drewarney/Turbocore-Maglev-Compressor-analysis/report/figures/S2_TipLeakage_streamlines.png

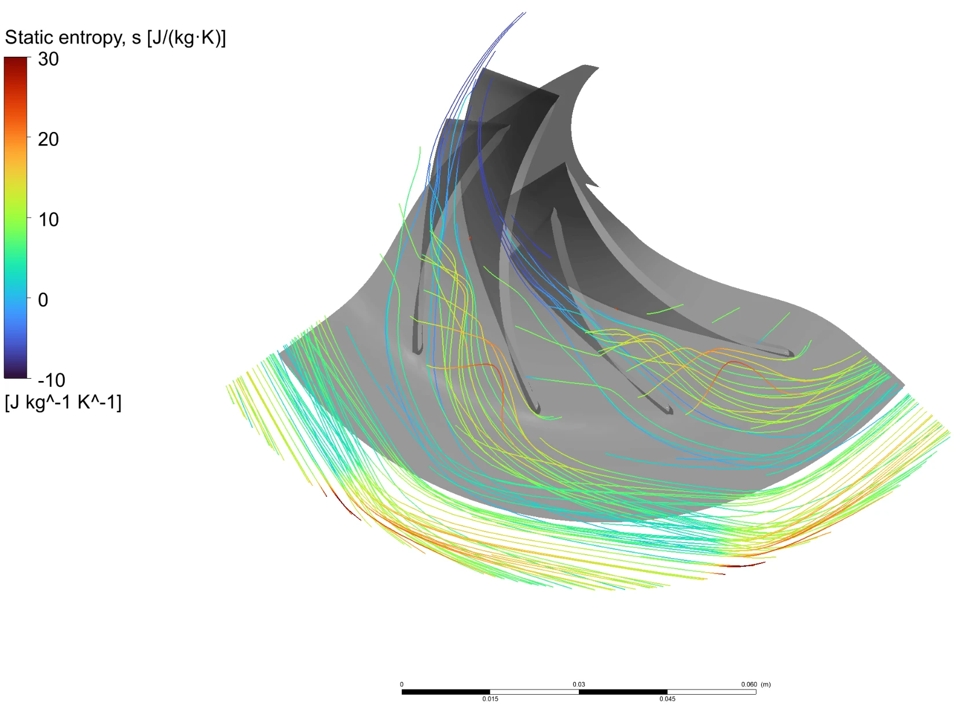
report/figures/S2_TipLeakage_streamlines.png
