drewarney/Turbocore-Maglev-Compressor-analysis/drawings/SK-001_impeller_mounting.pdf

# (a) Clamped stack: nut / tie bolt, torque by face friction

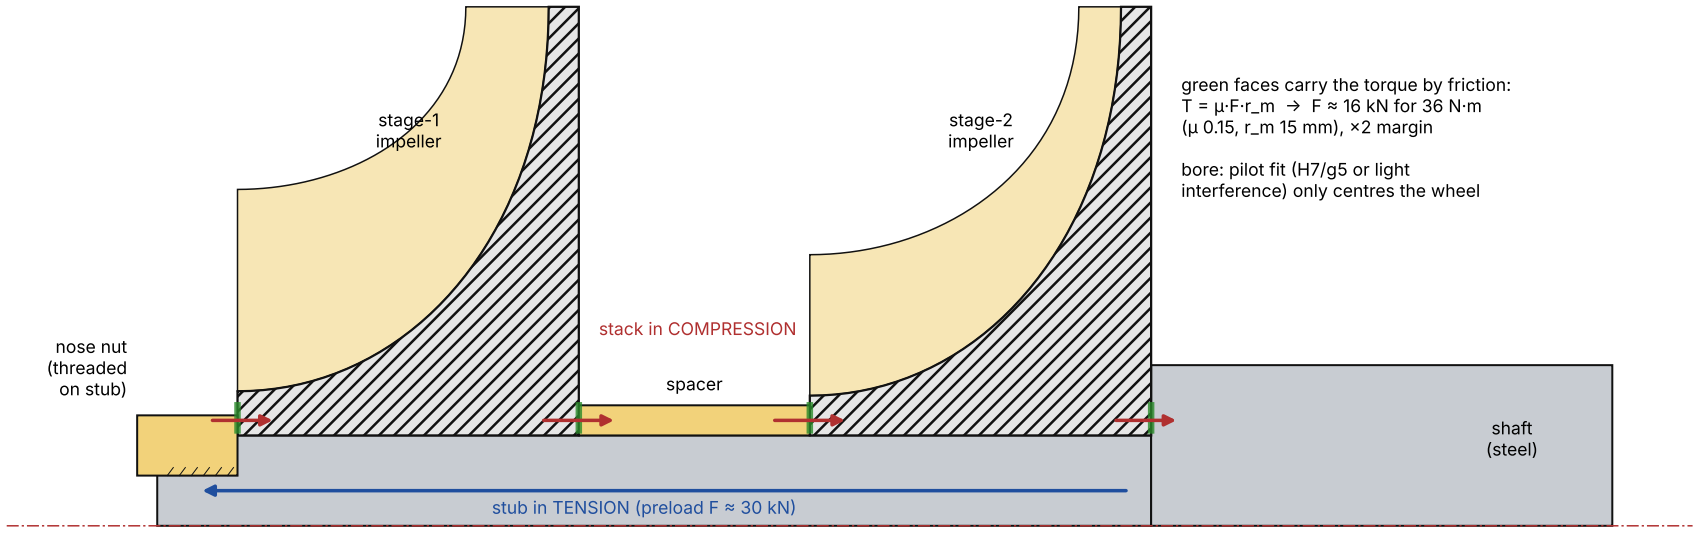
[picture p19: figure]
shaft (steel); stage-1 impeller; stage-2 impeller; spacer; nose nut (threaded on stub); stub in TENSION (preload F ≈ 30 kN); stack in COMPRESSION; T = μ·F·r_m → F ≈ 16 kN for 36 N·m (μ 0.15, r_m 15 mm), ×2 margin; bore: pilot fit (H7/g5 or light; interference) only centres the wheel

green faces carry the torque by friction:

+ easy to assemble and service
+ balance stays repeatable
− needs flat, square faces (datum A)

# (b) Shrink (interference) fit: torque by bore pressure

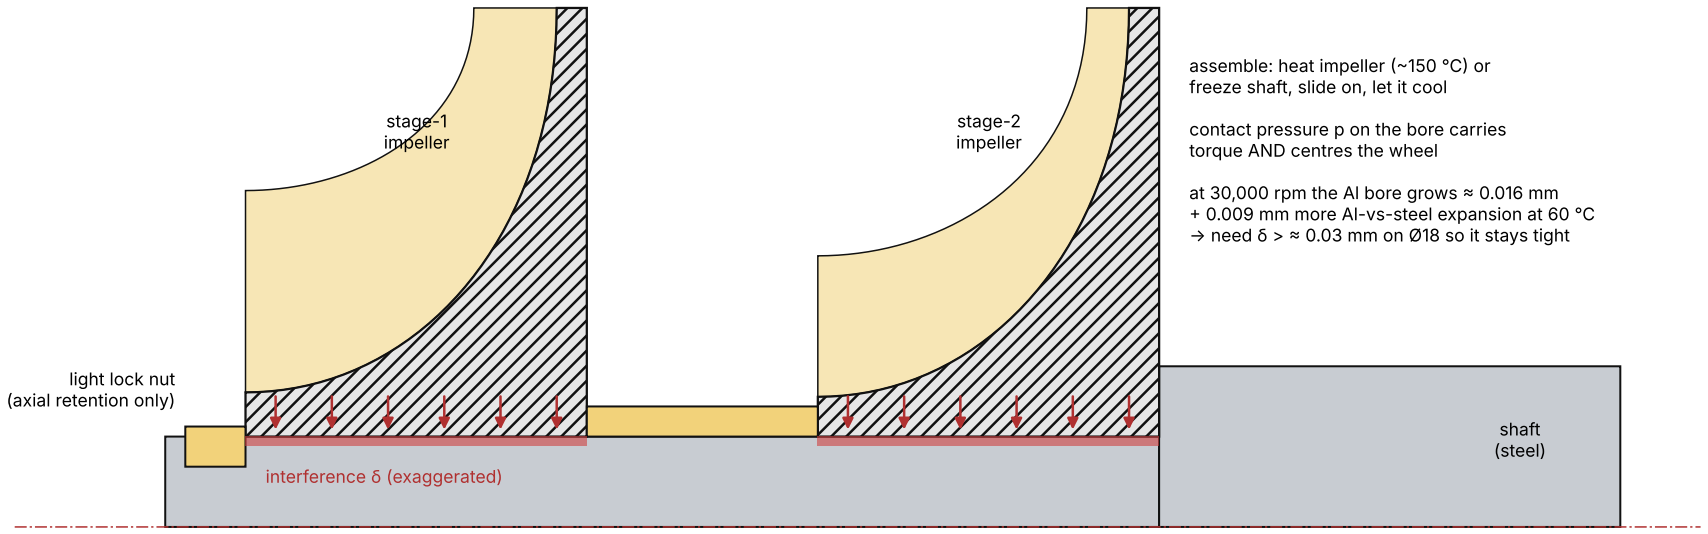
[picture p20: figure]
shaft (steel); stage-1 impeller; stage-2 impeller; light lock nut (axial retention only); interference δ (exaggerated); assemble: heat impeller (~150 °C) or; freeze shaft, slide on, let it cool; contact pressure p on the bore carries torque AND centres the wheel

at 30,000 rpm the Al bore grows ≈ 0.016 mm
+ 0.009 mm more Al-vs-steel expansion at 60 °C → need δ > ≈ 0.03 mm on Ø18 so it stays tight

+ no torque on the faces, very stiff
− hard to remove; heating can change 7075-T6 temper above ~120 °C
− fit loosens with speed and temperature

Half-sections above the rotor axis, to scale (layout.py). Blades in yellow, hub body hatched. Study schematic - the real Turbocor mounting is not published.
