drewarney/Turbocore-Maglev-Compressor-analysis/calcs/FBD_set.pdf

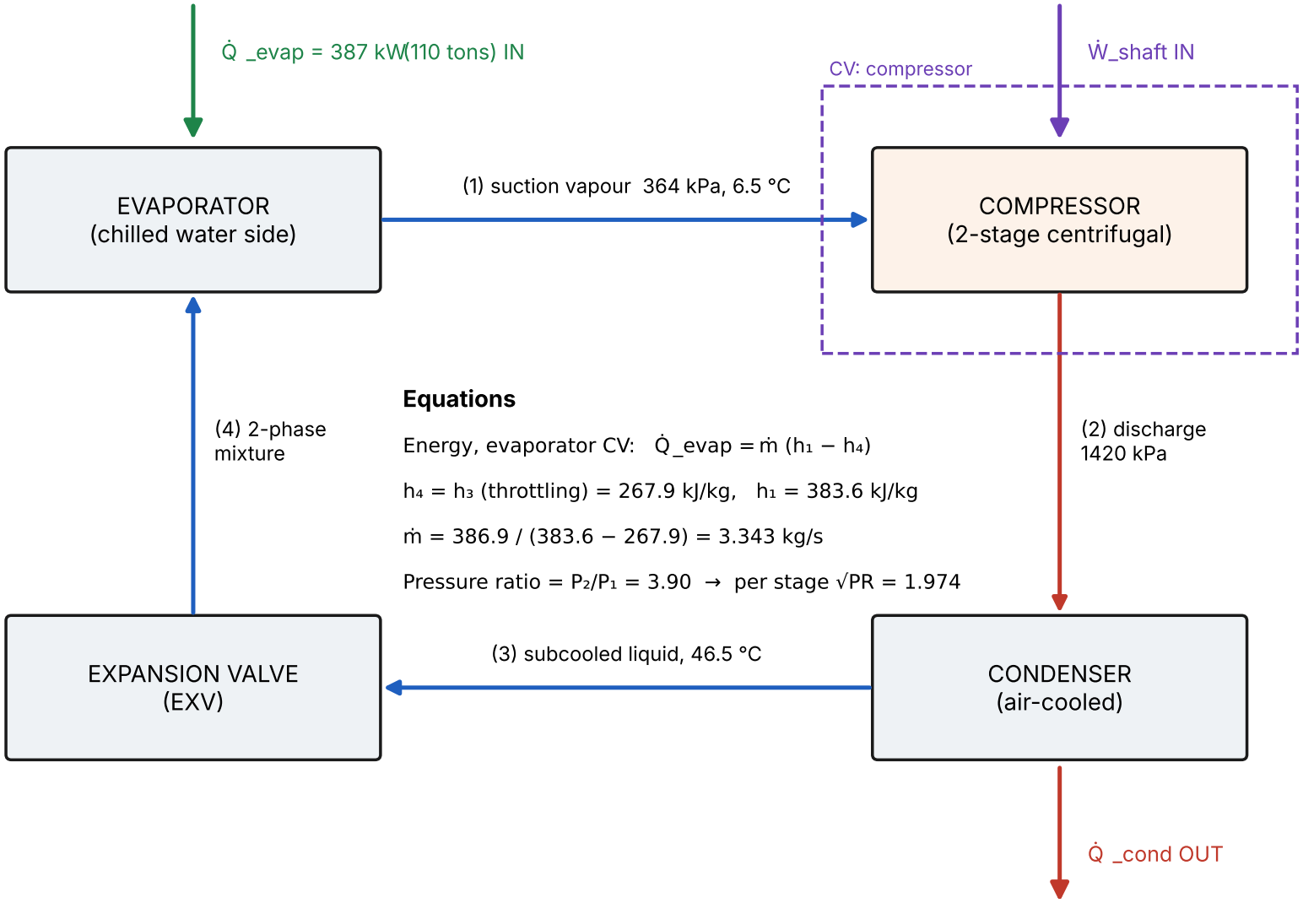
[picture p21: figure]
EVAPORATOR (chilled water side); COMPRESSOR (2-stage centrifugal); CONDENSER (air-cooled); EXPANSION VALVE (EXV); (1) suction vapour 364 kPa, 6.5 °C; (2) discharge; 1420 kPa; (3) subcooled liquid, 46.5 °C; (4) 2-phase; mixture; Q̇Q̇ _cond OUT; CV: compressor; Equations

Q̇Q̇ _evap = 387 kW (110 tons) IN | Ẇ_shaft IN

Energy, evaporator CV: Q̇Q̇ _evap = ṁ (h₁ − h₄)

h₄ = h₃ (throttling) = 267.9 kJ/kg, h₁ = 383.6 kJ/kg

ṁ = 386.9 / (383.6 − 267.9) = 3.343 kg/s

Pressure ratio = P₂/P₁ = 3.90 → per stage √PR = 1.974

# FBD-1 Chiller refrigeration cycle: system control volumes

Turbocor-class compressor study: free-body / control-volume diagrams. Numbers from scripts/hand_calcs.py.

### COMPRESSOR (stages 1 + 2)

control surface

ṁ = 3.343 kg/s
h₀₁ = 383.6 kJ/kg
P₀₁ = 364 kPa

## h₀₂ = h₀₁ + Δh₀

P₀₂ = 1420 kPa

Ẇ_gas = 110.5 kW (shaft work on gas)

Q̇Q̇ ≈ 0 (adiabatic; motor-cooling flow handled separately)

## Equations

Steady-flow energy: Ẇ = ṁ (h₀₂ − h₀₁) (Q̇Q̇ ≈ 0, ΔPE ≈ 0)

Ideal (isentropic): Δh₀s = h₂s − h₁ = 26.17 kJ/kg

Actual (meanline): Δh₀ = 33.07 kJ/kg → η_s = 0.792

Ẇ_gas = 3.343 × 33.07 = 110.5 kW

# FBD-2 Compressor control volume: first law (steady flow)

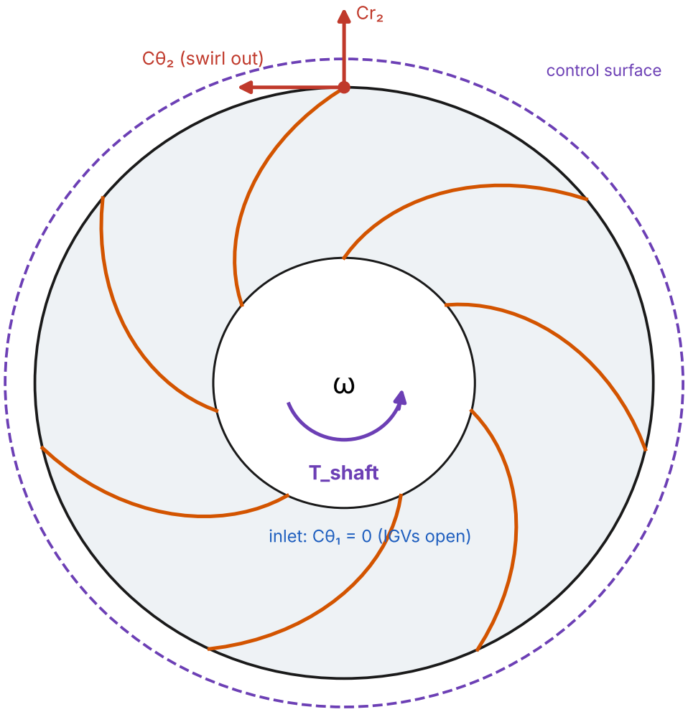
[picture p22: figure]
control surface; T_shaft; Cθ₂ (swirl out); Cr₂; inlet: Cθ₁ = 0 (IGVs open)

## Equations

Angular momentum about the shaft axis:

T_shaft = ṁ (r₂Cθ₂ − r₁Cθ₁)

Power: Ẇ = T ω = ṁ (U₂Cθ₂ − U₁Cθ₁)

With Cθ₁ = 0: Δh₀ = U₂ Cθ₂

Slip (Wiesner): σ = 1 − √(cos β₂b) / Z^0.7

Z = 14, β₂b = 40° → σ = 0.862

Cθ₂ = σU₂ − Cm₂ tan β₂b, Cm₂ = φ₂U₂

ψ = Δh₀/U₂² = σ − φ₂ tan β₂b = 0.627

U₂ = 162.4 m/s → Δh₀ = 16.53 kJ/kg

D₂ = 60U₂/(πN) = 103.4 mm (N = 30,000 rpm)

Stage-1 torque = ṁΔh₀/ω = 17.6 N·m

# FBD-3 Impeller control volume: angular momentum (Euler turbomachine equation)

## C₁ = Cm₁

= 66.7

## U₁t = 105.2

## W₁t = 124.6

## INLET (blade tip)

β₁t = atan(U₁t/Cm₁) = 57.6° from axial; M₁rel = W₁t/a₁ = 0.88

U₂ = 162.4

C₂ = 111.5 | W₂ = 75.7 blade direction (β₂b = 40°)

## EXIT (r₂ = 51.7 mm)

Cθ₂ = σU₂ − Cm₂tanβ₂b = 101.8; α₂ = atan(Cθ₂/Cm₂) = 65.9° from radial

50 m/s

Vector relation at every point: C = U + W (absolute = blade + relative)

Slip: the gas leaves at a smaller swirl than the blade angle implies (σ < 1)

# FBD-4 Velocity triangles (kinematics): stage-1 inlet tip and exit, to scale

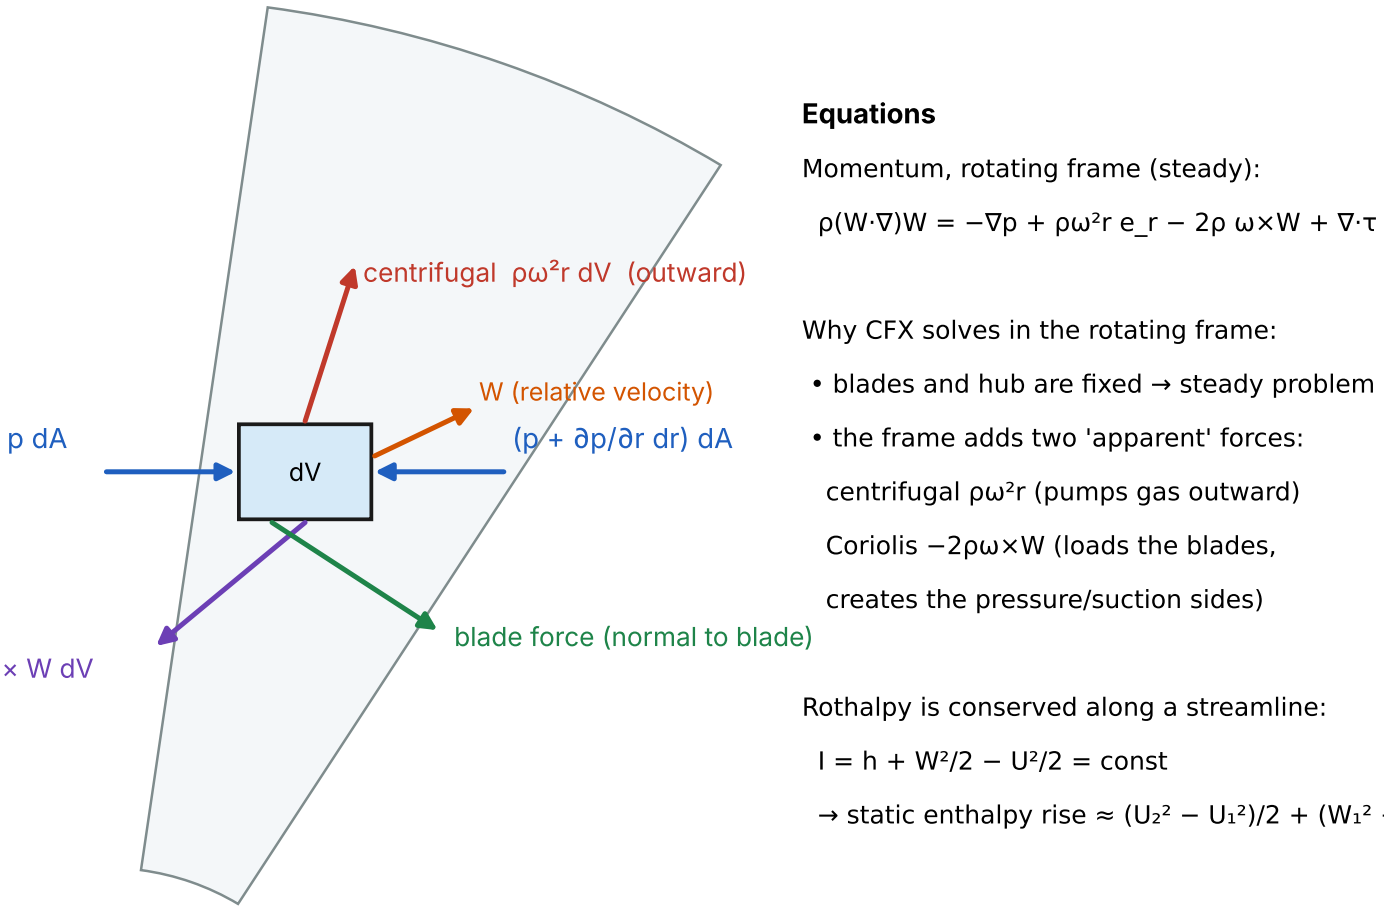
[picture p23: figure]
centrifugal ρω²r dV (outward); blade force (normal to blade); W (relative velocity); Equations; Momentum, rotating frame (steady):; ρ(W·∇)W = −∇p + ρω²r e_r − 2ρ ω×W + ∇·τ; Why CFX solves in the rotating frame:; • the frame adds two 'apparent' forces:; centrifugal ρω²r (pumps gas outward); Coriolis −2ρω×W (loads the blades,; creates the pressure/suction sides); I = h + W²/2 − U²/2 = const

axis (ω)

Coriolis −2ρ ω × W dV

- blades and hub are fixed → steady problem

Rothalpy is conserved along a streamline:

→ static enthalpy rise ≈ (U₂² − U₁²)/2 + (W₁² − W₂²)/2

# FBD-5 Fluid particle in the rotating passage (relative frame): forces per unit volume

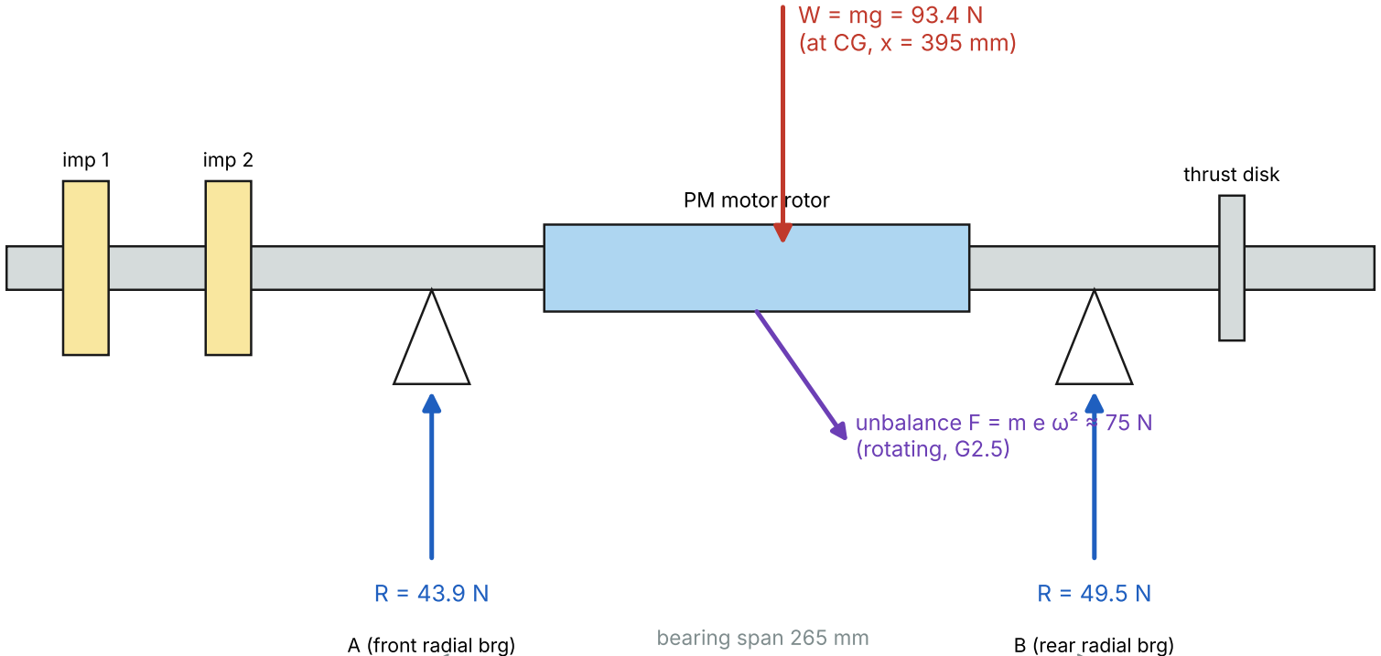
[picture p24: figure]
PM motor rotor; imp 1; imp 2; thrust disk; unbalance F = m e ω² ≈ 75 N (rotating, G2.5); bearing span 265 mm

A (front radial brg)

B (rear radial brg)

ΣF_y = 0: R_A + R_B = W = 9.52 kg × 9.81 = 93.4 N

ΣM_A = 0: R_B (x_B − x_A) = W (x_CG − x_A) → R_B = 49.5 N, R_A = 43.9 N

Unbalance (ISO 1940 G2.5): e = G/ω = 0.80 μm → F = m e ω² = 75 N (rotates at 1×)

Torque balance (steady): T_motor = T_aero = 35.9 N·m

# FBD-6 Rotor: radial free-body diagram (gravity, bearings, unbalance, torque)

## Stage-1 impeller

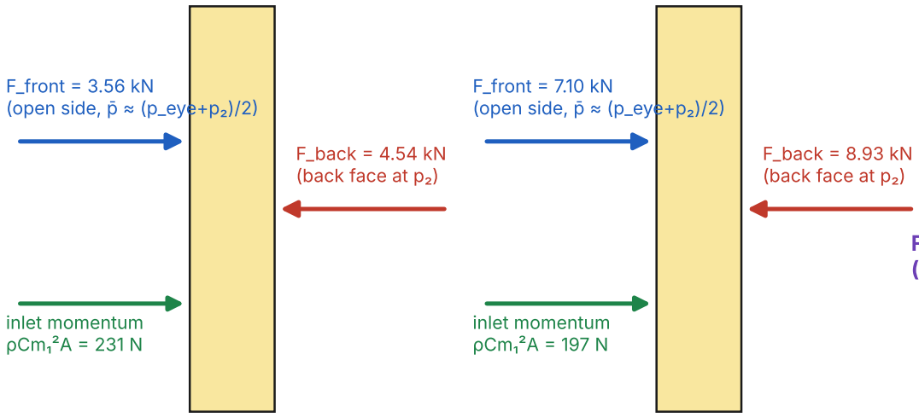
[picture p25: figure]
F_front = 3.56 kN (open side, p̄p̄ ≈ (p_eye+p₂)/2); inlet momentum ρCm₁²A = 231 N; F_back = 4.54 kN (back face at p₂); F_front = 7.10 kN (open side, p̄p̄ ≈ (p_eye+p₂)/2); inlet momentum ρCm₁²A = 197 N; F_back = 8.93 kN (back face at p₂)

## net = 0.75 kN → suction

## Stage-2 impeller

## net = 1.63 kN → suction

thrust disk

## F_axial brg ≈ 2.38 kN (reaction, toward motor)

← suction end (−X) | motor end (+X) →

Stage 1: p_eye = 324 kPa, p₂ = 572 kPa; Stage 2: p_eye = 665 kPa, p₂ = 1124 kPa

ΣF_x = 0: F_axial = Σ(F_back − F_front − ρCm₁²A) = 2.38 kN (net push toward suction; ESTIMATE)

Real machines cut this with labyrinth seals / balance holes / back-to-back cavities; the axial bearing takes the rest.

# FBD-7 Impellers: axial free-body diagram (pressure thrust, momentum, axial bearing)

## σ_θ

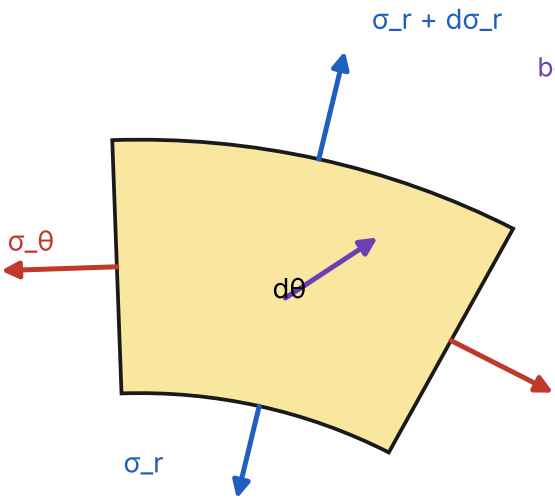
[picture p26: figure]

body force ρω²r · (r dθ dr t)

axis

## Equations

Radial equilibrium of the element:

d(r σ_r)/dr − σ_θ + ρω²r² = 0

Solution, flat disc with bore r_b (plane stress):

σ_θ,max (at bore) = (3+ν)/4 · ρω² [r₂² + (1−ν)/(3+ν) r_b²]

7075-T6: ρ = 2810 kg/m³, ν = 0.33, S_y = 503 MPa

r₂ = 51.7 mm, r_b = 9 mm

30,000 rpm: σ_θ = 62 MPa

34,500 rpm (115 %): σ_θ = 82 MPa → SF = 6.1

39,000 rpm (max): σ_θ = 105 MPa

Blades add load at the hub → confirm with FEA.

# FBD-8 Impeller disc: differential element under centrifugal load (overspeed check)
