drewarney/Turbocore-Maglev-Compressor-analysis/drawings/Turbocor_drawing_set.pdf

# COVER SHEET & DESIGN BASIS

Turbocor-class 2-stage maglev centrifugal compressor (R-513A) | SHEET 1 OF 12
DWG TC-000 SCALE - UNITS mm | REV A 2026-10-17
Reverse-engineered study model - NOT OEM geometry. Third-angle projection. General tolerance +/-0.5 mm unless noted.

# TURBOCOR-CLASS TWO-STAGE MAGNETIC-BEARING CENTRIFUGAL COMPRESSOR

Study model for SolidWorks + Ansys CFD | Basis: Danfoss Turbocor TTS350 as used in the Trane TCAA air-cooled chiller (IOM TCA-SVX001C-EN)

### DESIGN POINT (from scripts/meanline.py)

Parameter | Value
Refrigerant | R-513A (R-1234yf/R-134a 56/44 wt%)
Capacity per compressor | 110 tons (387 kW)
Sat. suction / discharge | 3.5 C / 51.5 C
Suction / discharge pressure | 364 / 1420 kPa(a)
Overall pressure ratio | 3.90
Mass flow | 3.34 kg/s
Suction volume flow | 0.177 m3/s
Design speed | 30,000 rpm
Shaft power / torque | 113 kW / 35.9 N.m
Compressor kW/ton (est.) | 1.08
Discharge temperature | 60 C
Impeller tip dia. (both stages) | 103.4 mm, tip speed 162 m/s
Blades | 7 main + 7 splitter, backsweep 40 deg
Stage PR (1 / 2) | 1.979 / 1.970

### DRAWING INDEX

DWG | Title
TC-000 | Cover sheet & design basis
TC-100/1 | General arrangement - longitudinal section
TC-100/2 | General arrangement - exterior views
TC-101 | Impeller, stage 1
TC-102 | Impeller, stage 2
TC-103 | Rotor shaft assembly
TC-110 | Inlet housing & inlet guide vanes
TC-120 | Compressor casing flow path, de-swirl vanes
TC-121 | Volute
TC-130 | Motor stator & housing
TC-140 | Magnetic & touchdown bearings
CFD-001 | CFD fluid domains & boundary conditions

### NOTES

1. All dimensions mm. Coordinate system: X = rotor axis, X=0 at suction flange face, +X toward motor.
2. Impeller/flow-path coordinates are generated - import them from cad_curves/ rather than re-typing.
3. Geometry is a physics-based preliminary design (meanline), proportioned on Turbocor TT-class
4. machines. It is NOT the OEM design and must not be used for manufacture or service parts.
5. Re-run scripts/ to change design point (speed, tonnage, refrigerant) - every sheet regenerates.
6. Materials: impellers 7075-T6 / 2618-T61 Al; casing A356-T6 Al; shaft 17-4PH; rotor sleeve CFRP;
7. laminations M270-35A / Co-Fe for bearings; housing A356-T6 / ductile iron.

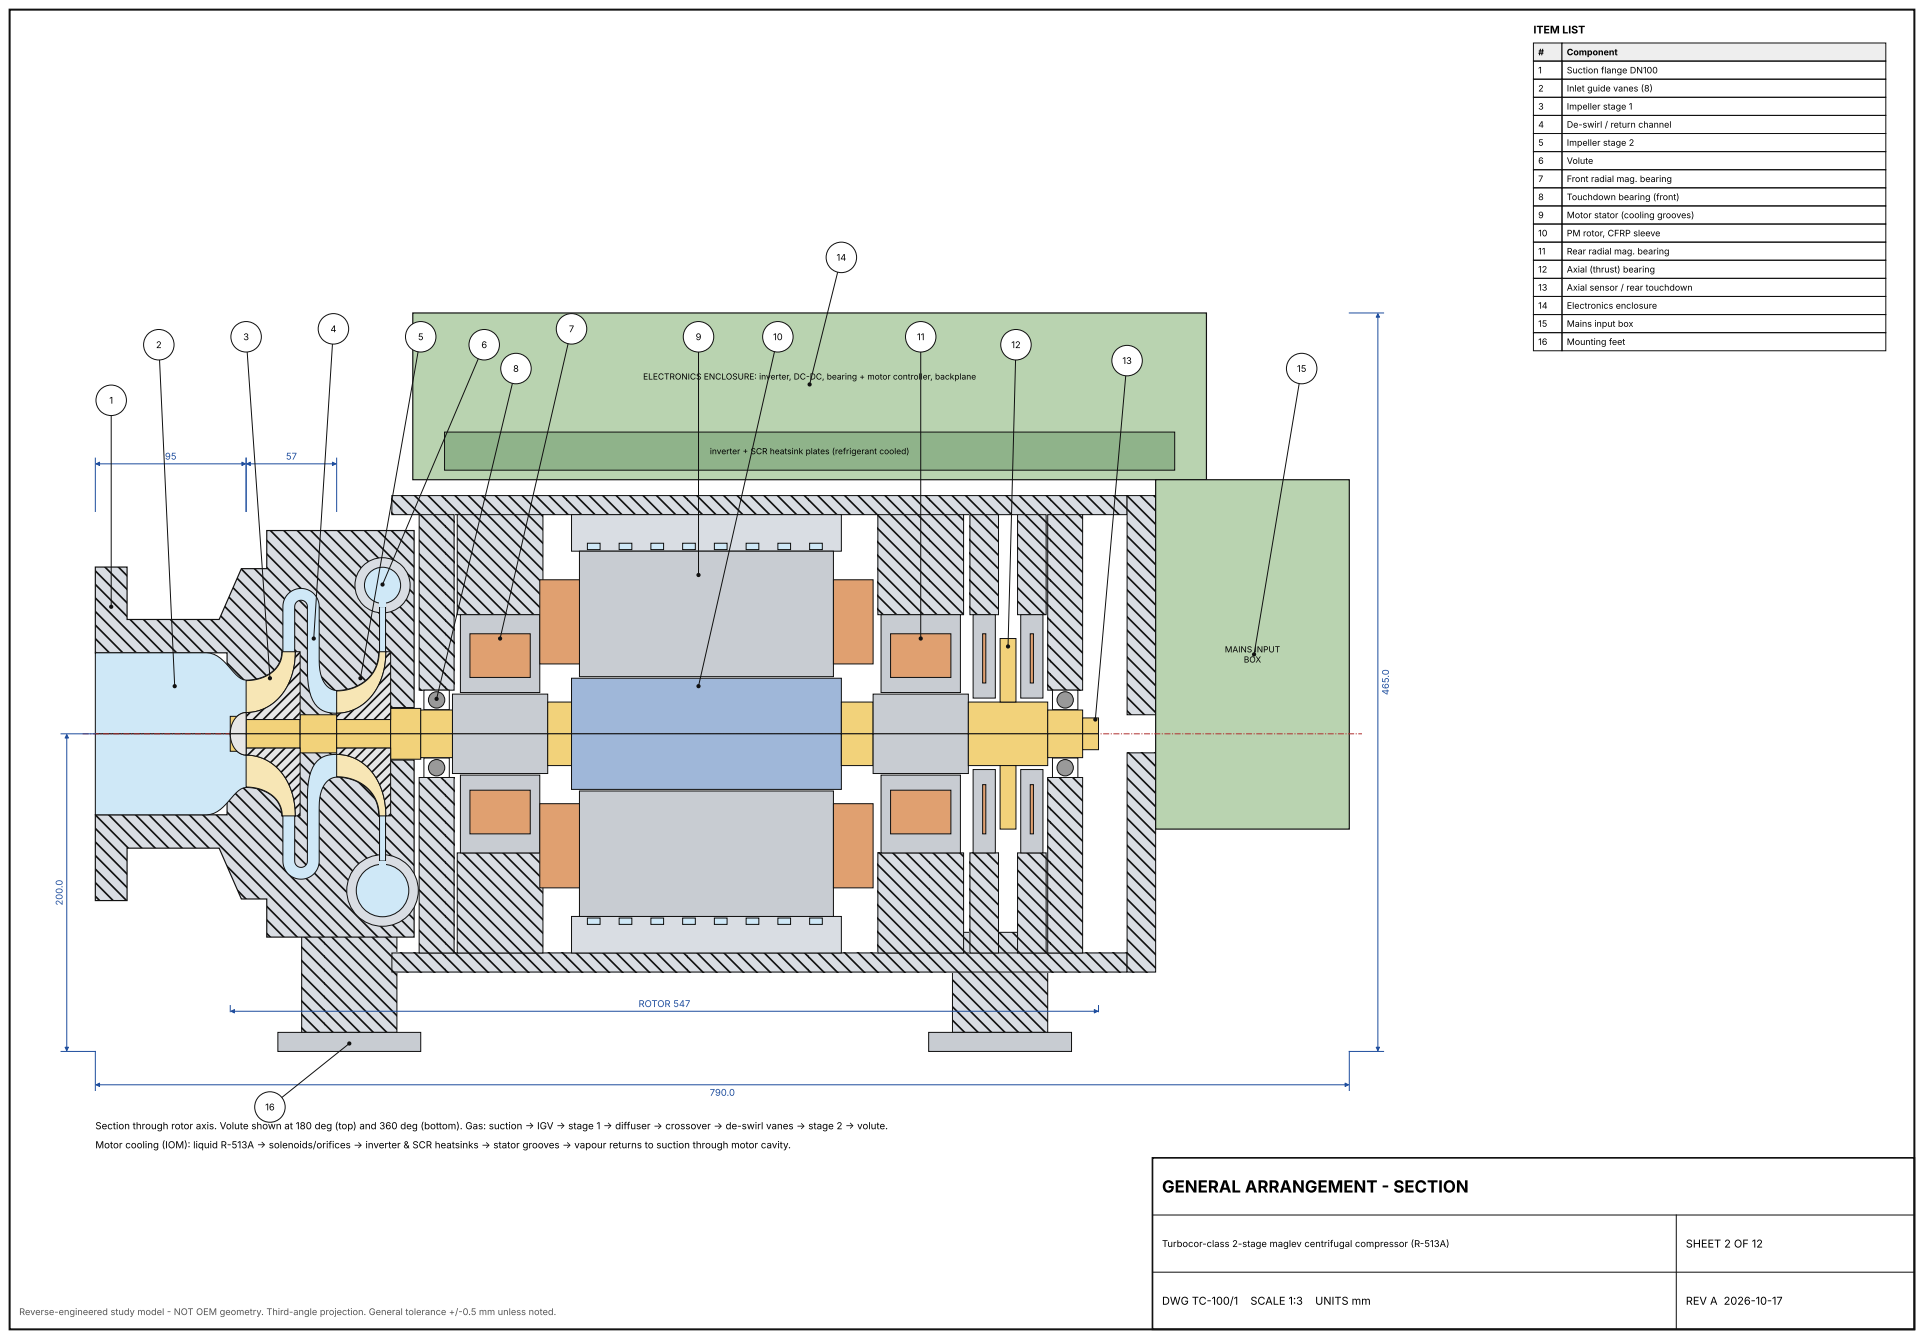
[picture p27: page 2]
SHEET 2 OF 12; ITEM LIST; Component; Suction flange DN100; Inlet guide vanes (8); Impeller stage 1; De-swirl / return channel; Impeller stage 2; Volute; Front radial mag. bearing; Touchdown bearing (front); Motor stator (cooling grooves); PM rotor, CFRP sleeve; Rear radial mag. bearing; Axial (thrust) bearing; Axial sensor / rear touchdown; Electronics enclosure; Mains input box; Mounting feet; MAINS INPUT BOX; ROTOR 547

ELECTRONICS ENCLOSURE: inverter, DC-DC, bearing + motor controller, backplane

inverter + SCR heatsink plates (refrigerant cooled)

Section through rotor axis. Volute shown at 180 deg (top) and 360 deg (bottom). Gas: suction -> IGV -> stage 1 -> diffuser -> crossover -> de-swirl vanes -> stage 2 -> volute.

Motor cooling (IOM): liquid R-513A -> solenoids/orifices -> inverter & SCR heatsinks -> stator grooves -> vapour returns to suction through motor cavity.

GENERAL ARRANGEMENT - SECTION

Turbocor-class 2-stage maglev centrifugal compressor (R-513A)

DWG TC-100/1 SCALE 1:3 UNITS mm

### SIDE ELEVATION 1:6

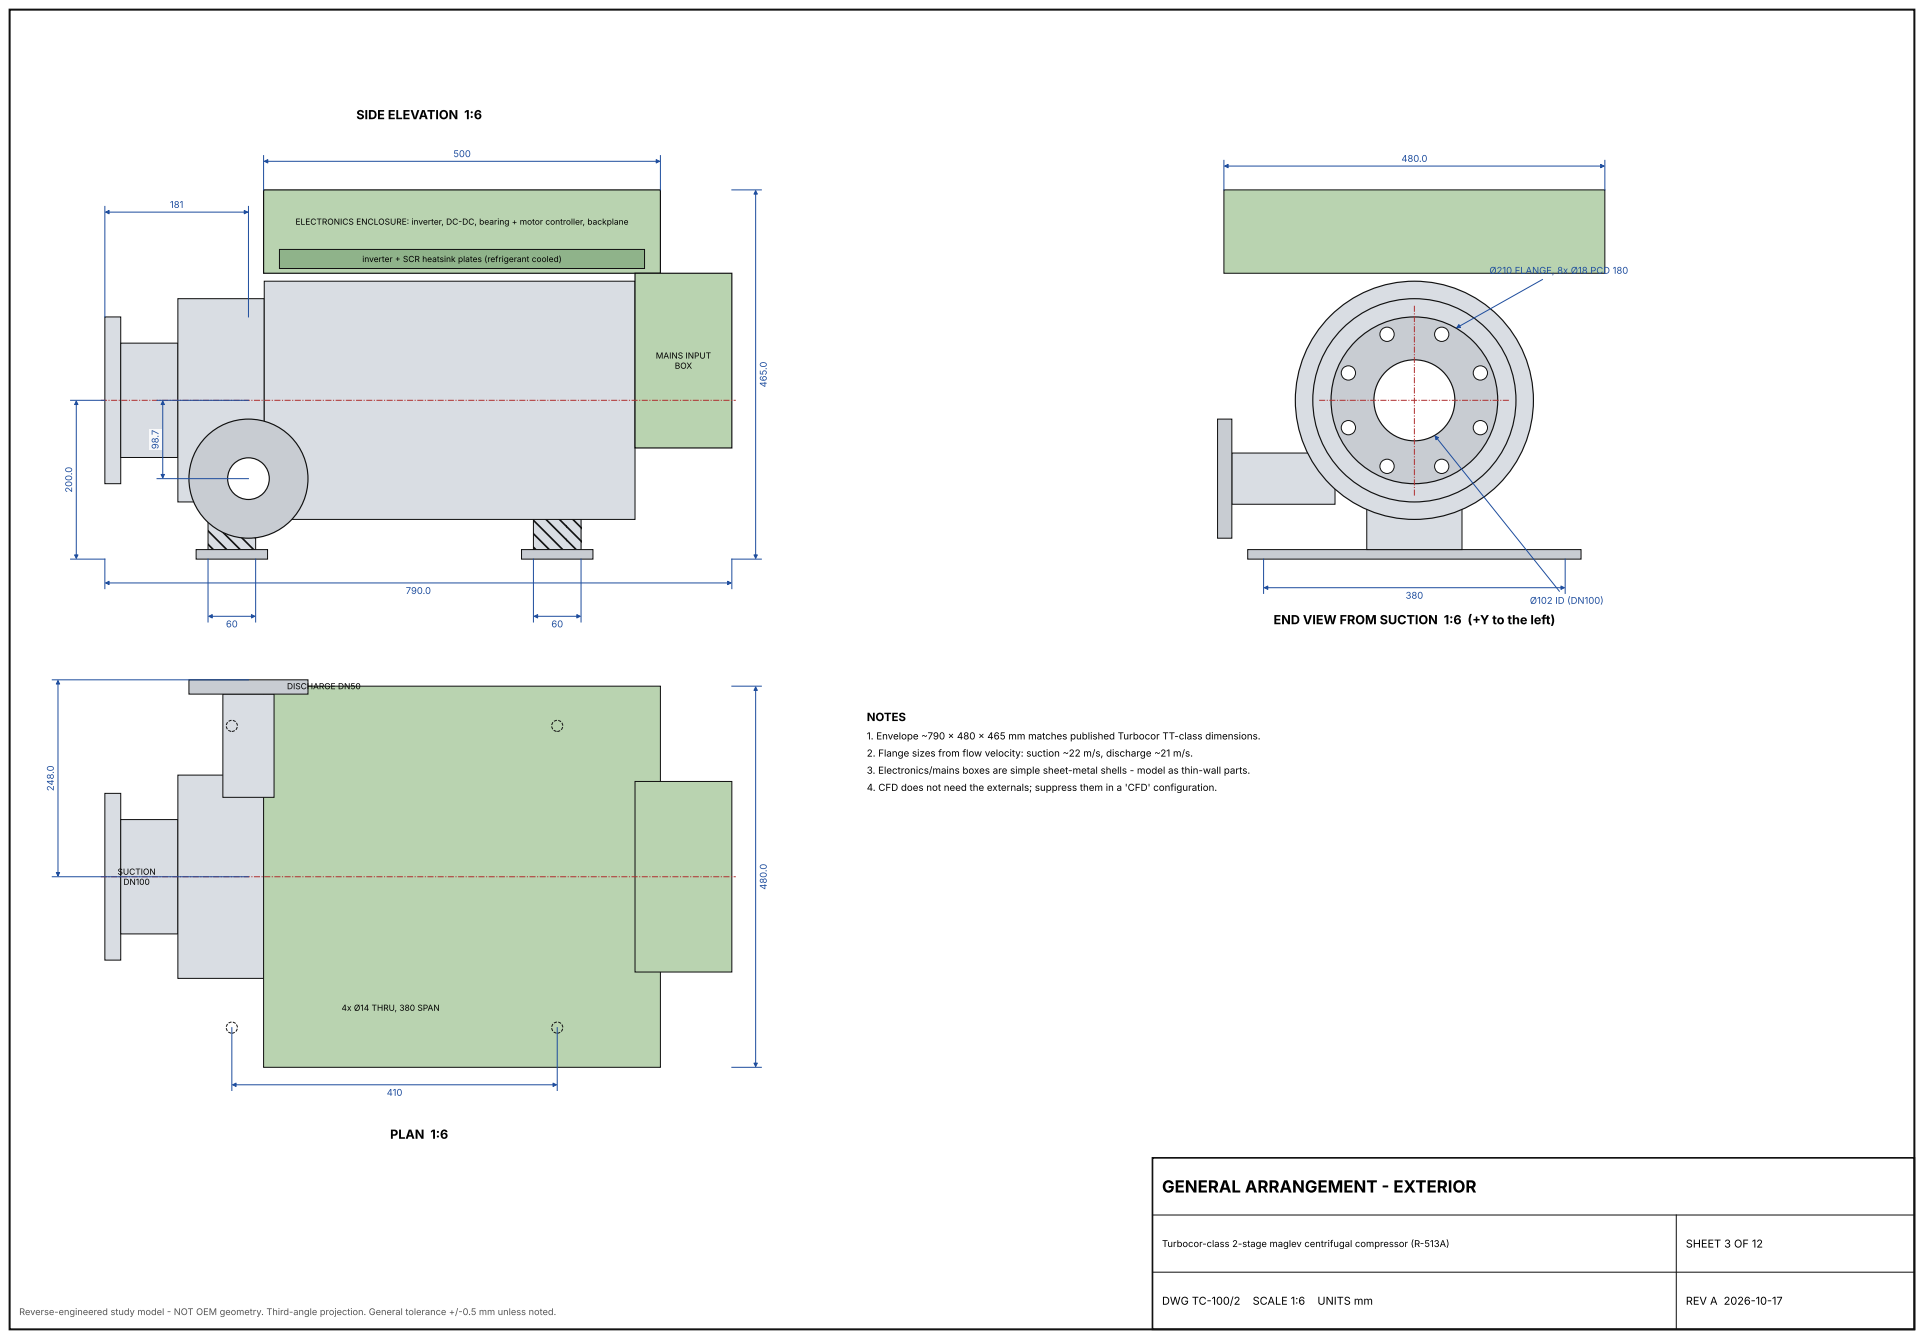
[picture p28: page 3]
SHEET 3 OF 12; PLAN 1:6; MAINS INPUT BOX; DISCHARGE DN50; SUCTION DN100; 4x Ø14 THRU, 380 SPAN; Ø210 FLANGE, 8x Ø18 PCD 180

ELECTRONICS ENCLOSURE: inverter, DC-DC, bearing + motor controller, backplane

inverter + SCR heatsink plates (refrigerant cooled)

END VIEW FROM SUCTION 1:6 (+Y to the left)

NOTES
1. Envelope ~790 x 480 x 465 mm matches published Turbocor TT-class dimensions.

2. Flange sizes from flow velocity: suction ~22 m/s, discharge ~21 m/s.
3. Electronics/mains boxes are simple sheet-metal shells - model as thin-wall parts.
4. CFD does not need the externals; suppress them in a 'CFD' configuration.

GENERAL ARRANGEMENT - EXTERIOR

Turbocor-class 2-stage maglev centrifugal compressor (R-513A)

DWG TC-100/2 SCALE 1:6 UNITS mm

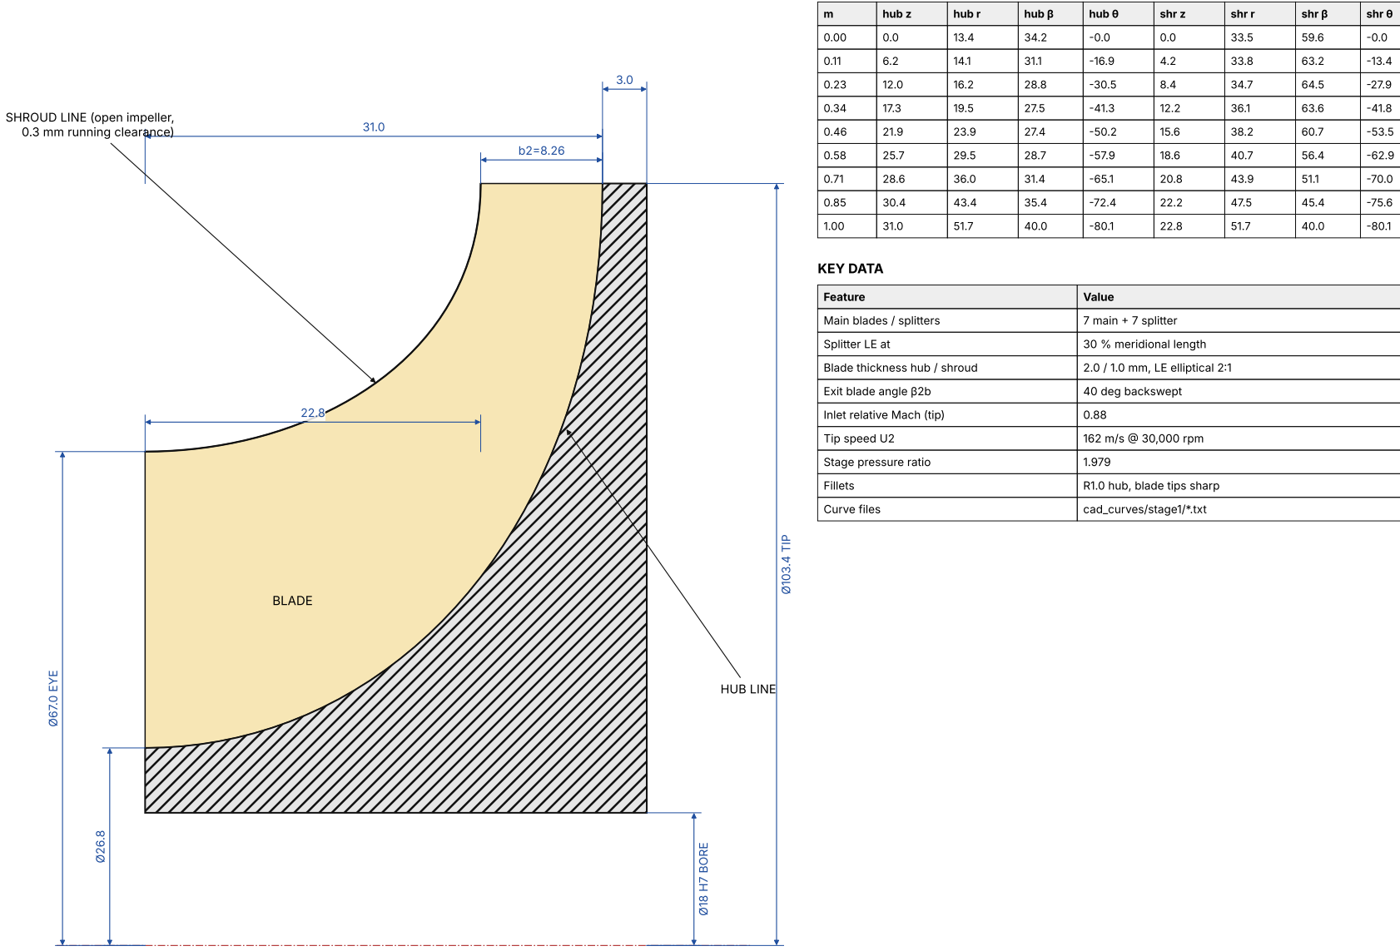
[picture p29: figure]
hub z; hub r; hub β; hub θ; shr z; shr r; shr β; shr θ; KEY DATA; Feature; Value; Main blades / splitters; 7 main + 7 splitter; Splitter LE at; 30 % meridional length; Exit blade angle β2b; 40 deg backswept; Inlet relative Mach (tip); Tip speed U2; 162 m/s @ 30,000 rpm; Stage pressure ratio; Fillets; R1.0 hub, blade tips sharp; Curve files; cad_curves/stage1/*.txt; Ø103.4 TIP; Ø18 H7 BORE; BLADE; SHROUD LINE (open impeller, 0.3 mm running clearance); HUB LINE

# IMPELLER - STAGE 1

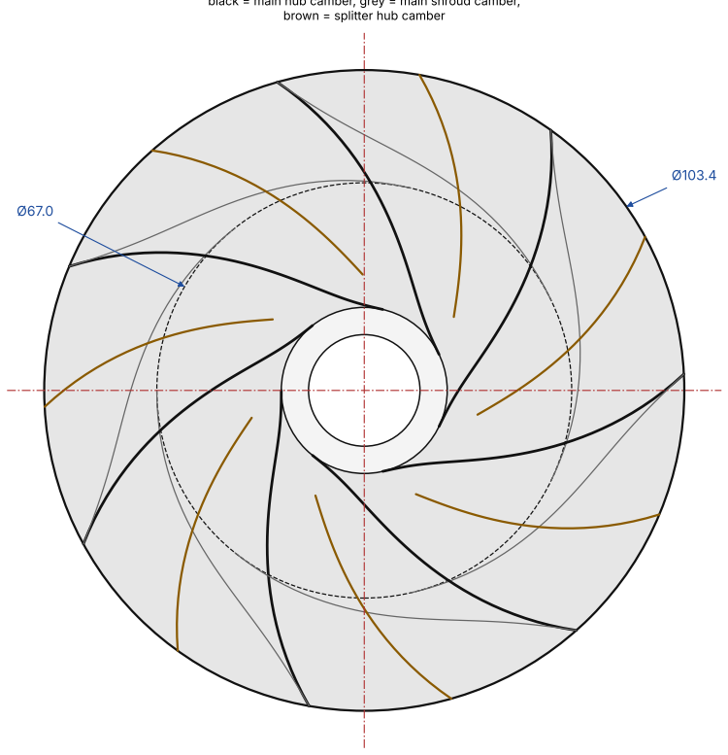
[picture p30: figure]
brown = splitter hub camber

Turbocor-class 2-stage maglev centrifugal compressor (R-513A)

DWG TC-101 SCALE 2.5:1 / 0.9:1 UNITS mm

SHEET 4 OF 12

MATERIAL: 7075-T6 aluminium (or 2618-T61), balance G1.0, overspeed 115%

### MERIDIONAL HALF-SECTION 2.5:1

BLADE DEFINITION (local z from eye, mm; β from meridional, θ wrap, deg)

Blade thickness hub / shroud | 2.0 / 1.0 mm, LE elliptical 2:1

### VIEW FROM INLET 0.9:1

NOTES

1. Machine from solid. Place eye plane at X = 95.0 in the assembly.
2. Blade = Boundary Surface between hub & shroud camber curves, Thicken 1.5 mm midplane.
3. Extend blade surfaces 1 mm past hub/shroud before Thicken, then trim (see guide).
4. Pattern blade 7x about axis; splitter pattern 7x offset by 25.71 deg.
5. Back face flat; balance holes optional. Tie-bolt clamps both impellers + spacer. Ø²⁶.8 Ø⁶⁷.0 EYE

ROTATION: CW VIEWED FROM INLET (+X right-hand) black = main hub camber, grey = main shroud camber,

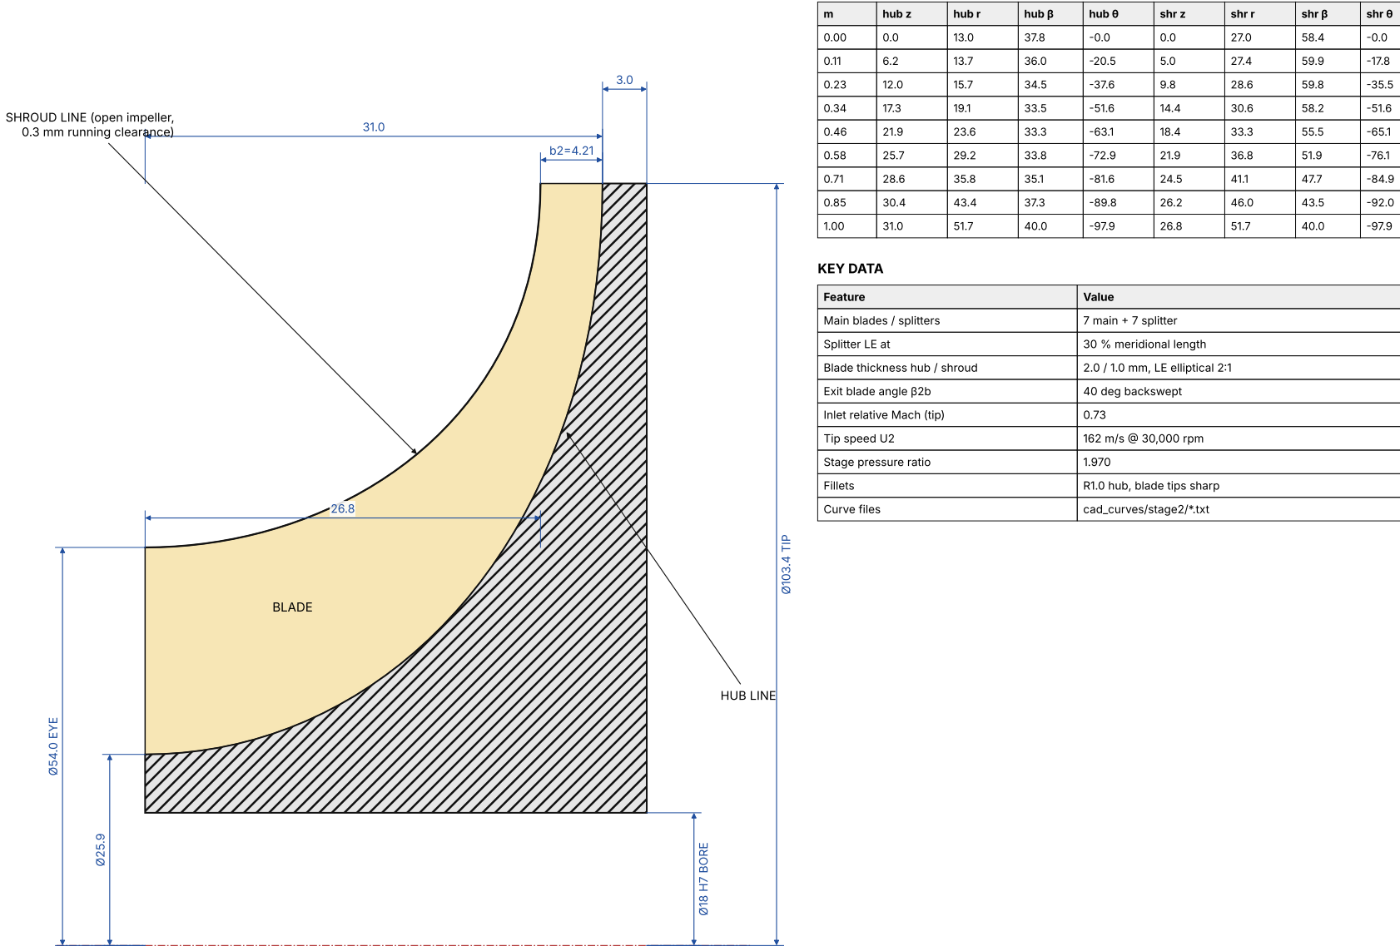
[picture p31: figure]
hub z; hub r; hub β; hub θ; shr z; shr r; shr β; shr θ; KEY DATA; Feature; Value; Main blades / splitters; 7 main + 7 splitter; Splitter LE at; 30 % meridional length; Exit blade angle β2b; 40 deg backswept; Inlet relative Mach (tip); Tip speed U2; 162 m/s @ 30,000 rpm; Stage pressure ratio; Fillets; R1.0 hub, blade tips sharp; Curve files; cad_curves/stage2/*.txt; Ø103.4 TIP; Ø18 H7 BORE; BLADE; SHROUD LINE (open impeller, 0.3 mm running clearance); HUB LINE

# IMPELLER - STAGE 2

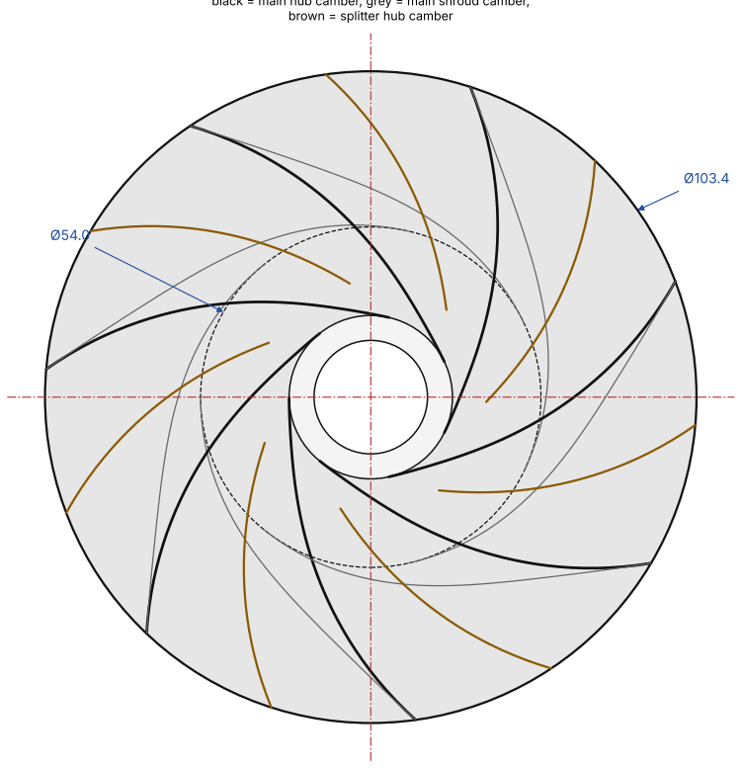
[picture p32: figure]
brown = splitter hub camber

Turbocor-class 2-stage maglev centrifugal compressor (R-513A)

DWG TC-102 SCALE 2.5:1 / 0.9:1 UNITS mm

SHEET 5 OF 12

MATERIAL: 7075-T6 aluminium (or 2618-T61), balance G1.0, overspeed 115%

### MERIDIONAL HALF-SECTION 2.5:1

BLADE DEFINITION (local z from eye, mm; β from meridional, θ wrap, deg)

Blade thickness hub / shroud | 2.0 / 1.0 mm, LE elliptical 2:1

### VIEW FROM INLET 0.9:1

NOTES

1. Machine from solid. Place eye plane at X = 152.0 in the assembly.
2. Blade = Boundary Surface between hub & shroud camber curves, Thicken 1.5 mm midplane.
3. Extend blade surfaces 1 mm past hub/shroud before Thicken, then trim (see guide).
4. Pattern blade 7x about axis; splitter pattern 7x offset by 25.71 deg.
5. Back face flat; balance holes optional. Tie-bolt clamps both impellers + spacer. Ø²⁵.9 Ø⁵⁴.0 EYE

ROTATION: CW VIEWED FROM INLET (+X right-hand) black = main hub camber, grey = main shroud camber,

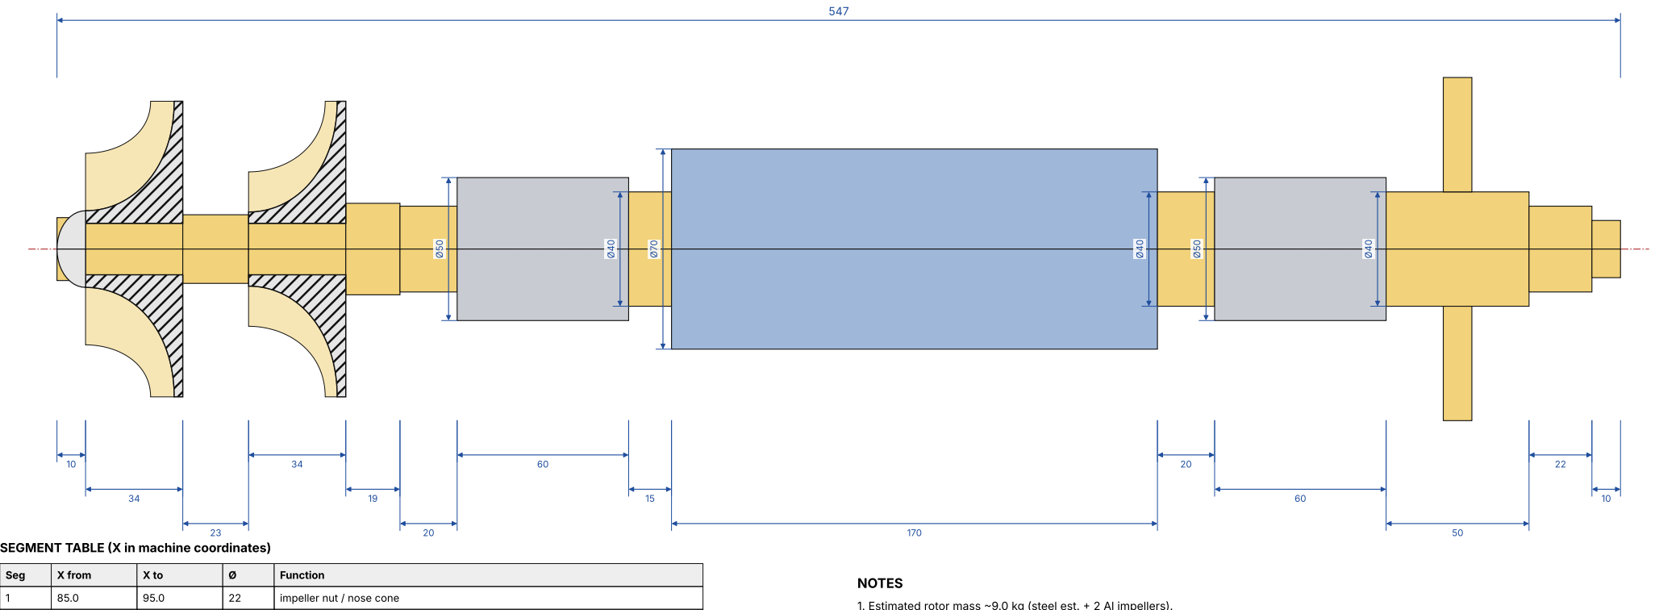
[picture p33: figure]
Seg; X from; Function; impeller nut / nose cone; NOTES

# ROTOR SHAFT ASSEMBLY

Turbocor-class 2-stage maglev centrifugal compressor (R-513A)

DWG TC-103 SCALE 1:2 UNITS mm

SHEET 6 OF 12

MATERIAL: 17-4PH H1025 shaft; CFRP magnet sleeve; Si-steel/Co-Fe bearing laminations

### ROTOR ELEVATION 1:2

SEGMENT TABLE (X in machine coordinates)

2 | 95.0 | 129.0 | 18 | stage-1 impeller seat
3 | 129.0 | 152.0 | 24 | interstage spacer sleeve
4 | 152.0 | 186.0 | 18 | stage-2 impeller seat
5 | 186.0 | 205.0 | 32 | seal sleeve
6 | 205.0 | 225.0 | 30 | front touchdown bearing journal
7 | 225.0 | 285.0 | 50 | front radial bearing rotor laminations
8 | 285.0 | 300.0 | 40 | shaft
9 | 300.0 | 470.0 | 70 | PM motor rotor (magnets + carbon-fibre sleeve)
10 | 470.0 | 490.0 | 40 | shaft
11 | 490.0 | 550.0 | 50 | rear radial bearing rotor laminations
12 | 550.0 | 600.0 | 40 | thrust-disk seat
13 | 600.0 | 622.0 | 30 | rear touchdown bearing journal
14 | 622.0 | 632.0 | 20 | axial / speed sensor target
TD | 570 | 580 | 120 | thrust disk (shrink fit, 17-4PH / Co-Fe)
1. Estimated rotor mass ~9.0 kg (steel est. + 2 Al impellers).
2. Model as ONE revolved part from the segment table, then split bodies for colour.
3. Impellers, spacer sleeve & nose nut clamped by an M10 tie-bolt (not shown).
4. Motor: 2-pole surface PM, Sm2Co17 magnets, 5 mm CFRP sleeve (tip speed ~110 m/s).
5. Radial air gap at mag-bearing journals 0.5 mm; touchdown clearance 0.2 mm radial.
6. First bending critical must stay >20% above 39,000 rpm max - check in Ansys Modal.

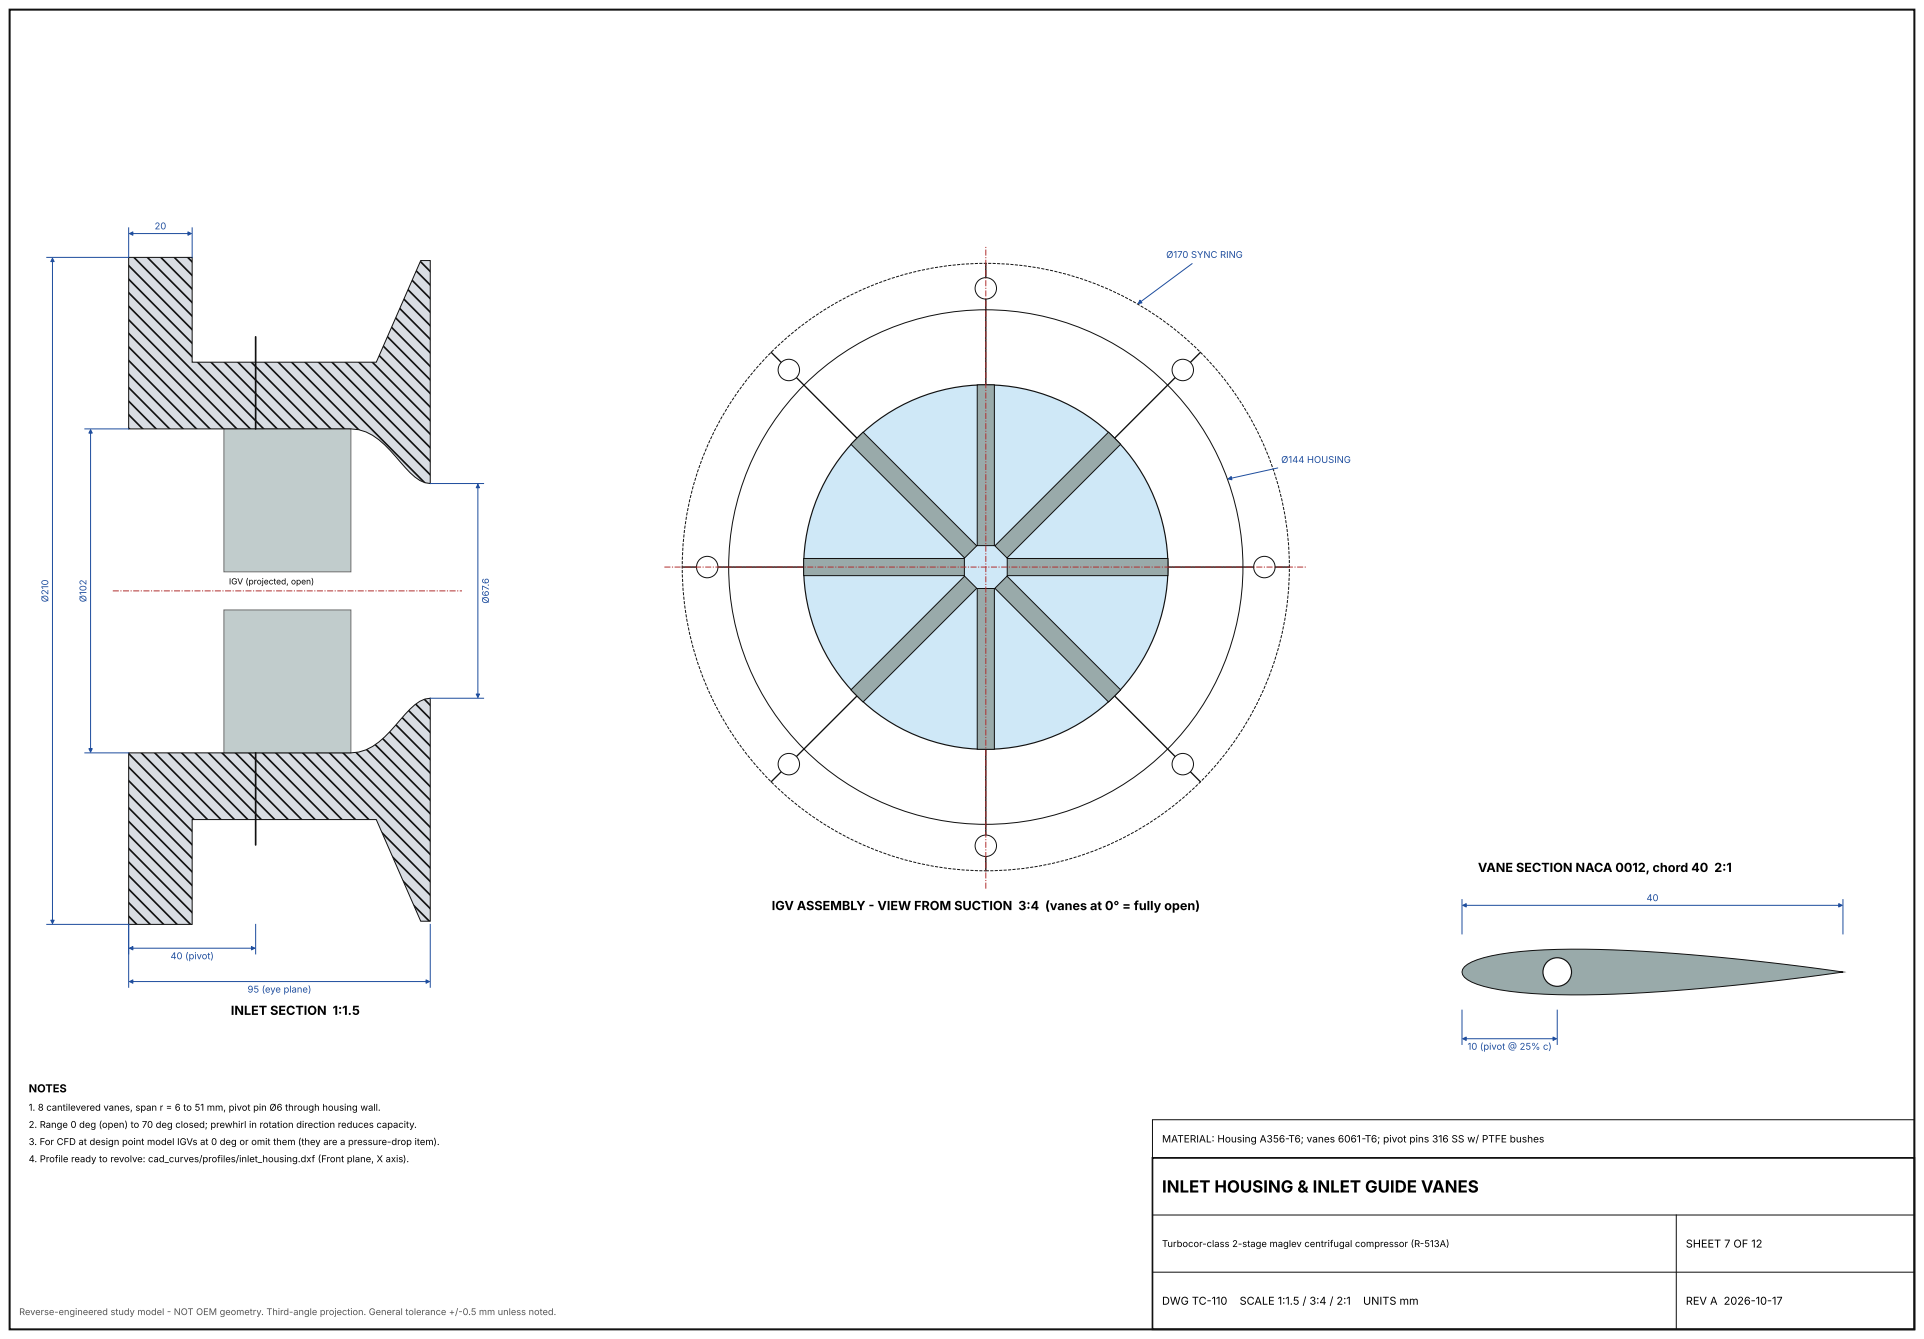
[picture p34: page 7]
SHEET 7 OF 12; INLET SECTION 1:1.5; NOTES; 40 (pivot); 95 (eye plane); 10 (pivot @ 25% c); Ø144 HOUSING; Ø170 SYNC RING

IGV (projected, open)

VANE SECTION NACA 0012, chord 40 2:1

IGV ASSEMBLY - VIEW FROM SUCTION 3:4 (vanes at 0° = fully open)

1. 8 cantilevered vanes, span r = 6 to 51 mm, pivot pin Ø6 through housing wall.
2. Range 0 deg (open) to 70 deg closed; prewhirl in rotation direction reduces capacity.
3. For CFD at design point model IGVs at 0 deg or omit them (they are a pressure-drop item).
4. Profile ready to revolve: cad_curves/profiles/inlet_housing.dxf (Front plane, X axis).

MATERIAL: Housing A356-T6; vanes 6061-T6; pivot pins 316 SS w/ PTFE bushes

INLET HOUSING & INLET GUIDE VANES

Turbocor-class 2-stage maglev centrifugal compressor (R-513A)

DWG TC-110 SCALE 1:1.5 / 3:4 / 2:1 UNITS mm

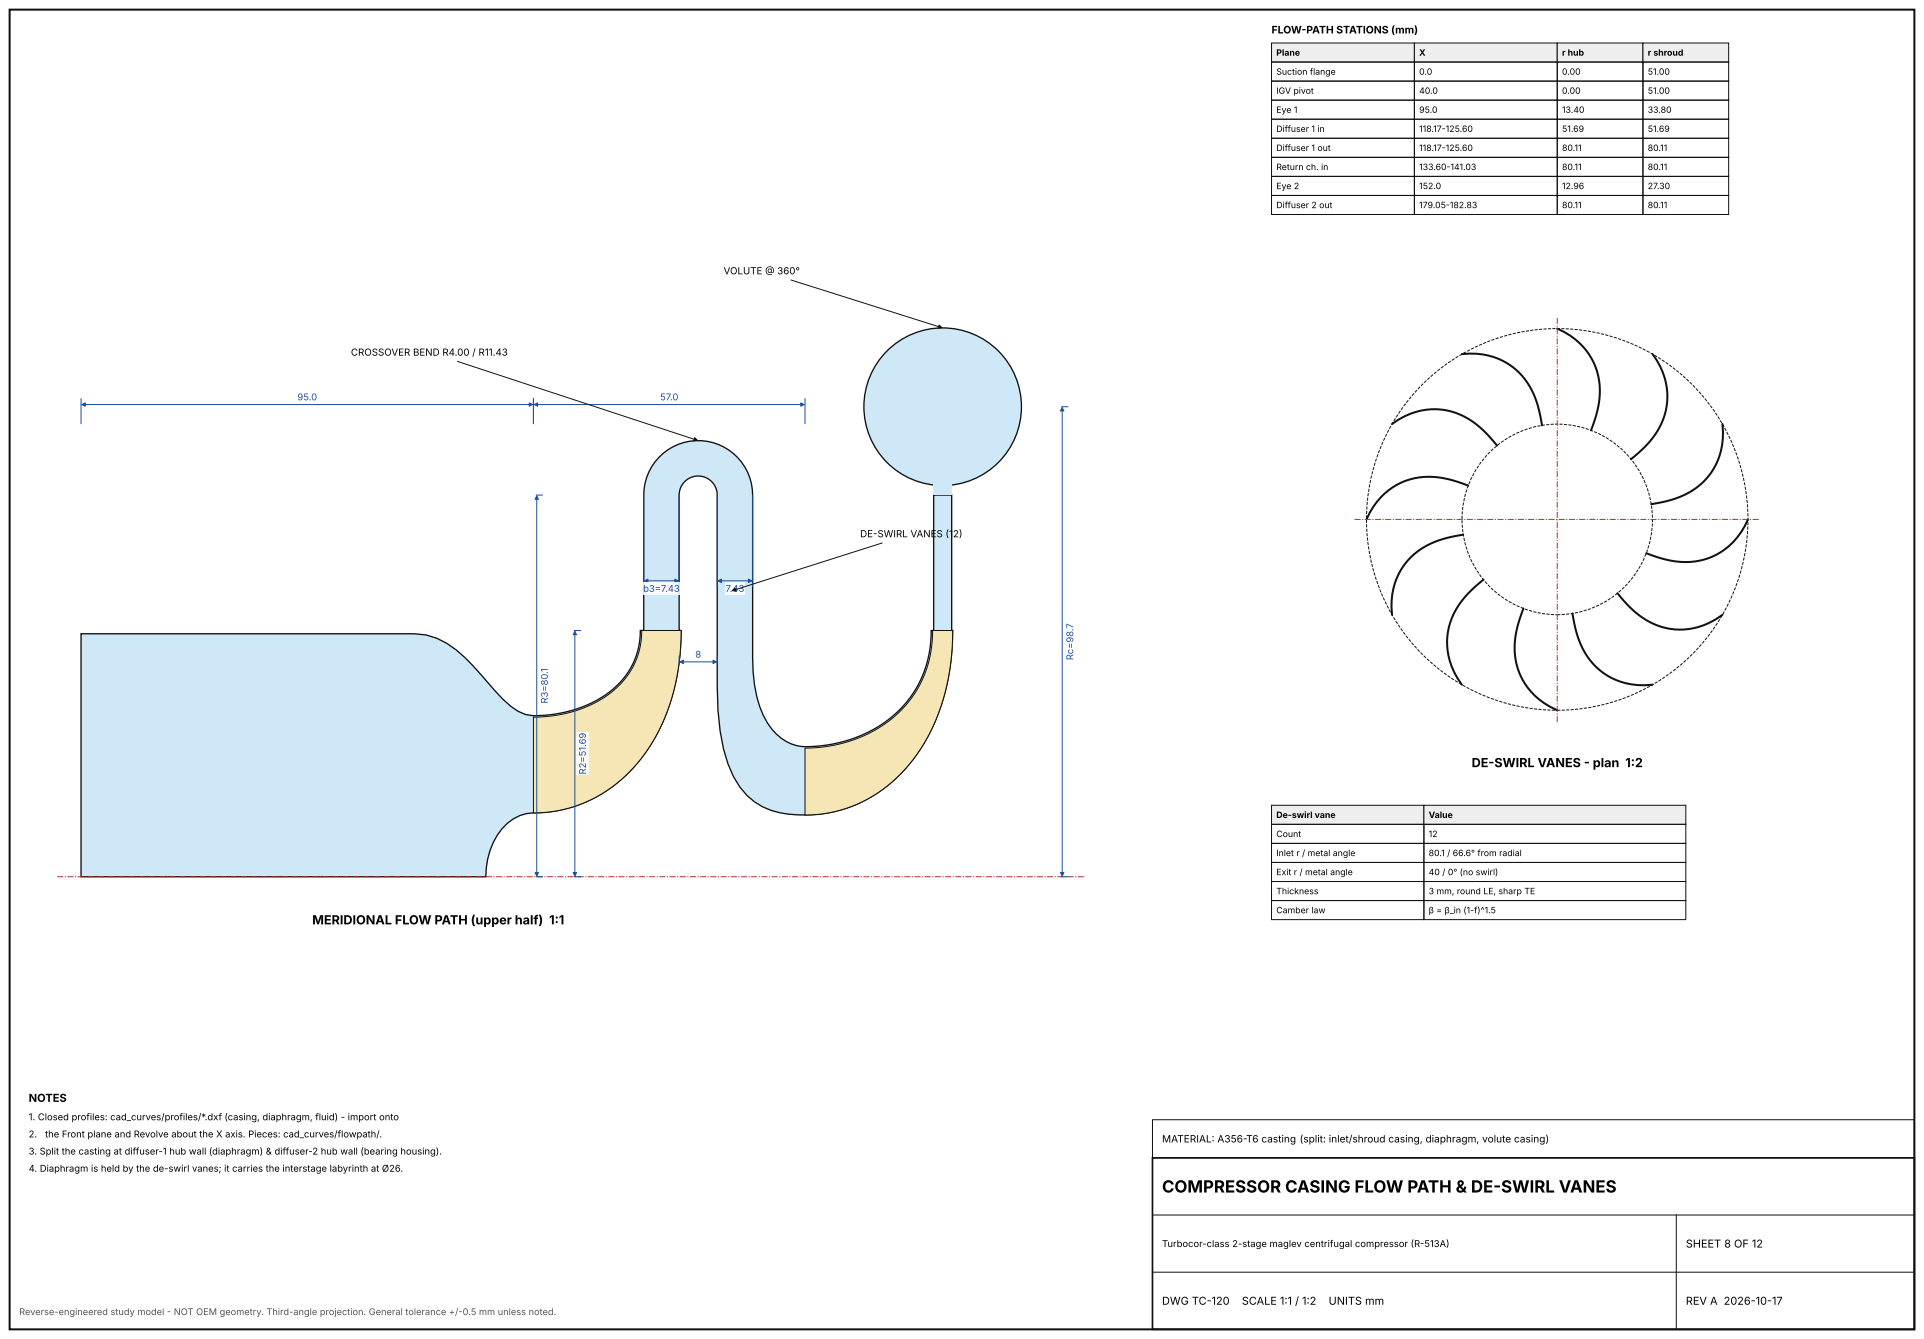
[picture p35: page 8]
SHEET 8 OF 12; Plane; r hub; r shroud; Suction flange; IGV pivot; Eye 1; Diffuser 1 in; Diffuser 1 out; Return ch. in; Eye 2; Diffuser 2 out; De-swirl vane; Value; Count; Inlet r / metal angle; 80.1 / 66.6° from radial; Exit r / metal angle; 40 / 0° (no swirl); Thickness; 3 mm, round LE, sharp TE; Camber law; CROSSOVER BEND R4.00 / R11.43; VOLUTE @ 360°

FLOW-PATH STATIONS (mm)

DE-SWIRL VANES (12)

DE-SWIRL VANES - plan 1:2

MERIDIONAL FLOW PATH (upper half) 1:1

NOTES
1. Closed profiles: cad_curves/profiles/*.dxf (casing, diaphragm, fluid) - import onto

2. the Front plane and Revolve about the X axis. Pieces: cad_curves/flowpath/.
3. Split the casting at diffuser-1 hub wall (diaphragm) & diffuser-2 hub wall (bearing housing).

MATERIAL: A356-T6 casting (split: inlet/shroud casing, diaphragm, volute casing)

4. Diaphragm is held by the de-swirl vanes; it carries the interstage labyrinth at Ø26.

COMPRESSOR CASING FLOW PATH & DE-SWIRL VANES

Turbocor-class 2-stage maglev centrifugal compressor (R-513A)

DWG TC-120 SCALE 1:1 / 1:2 UNITS mm

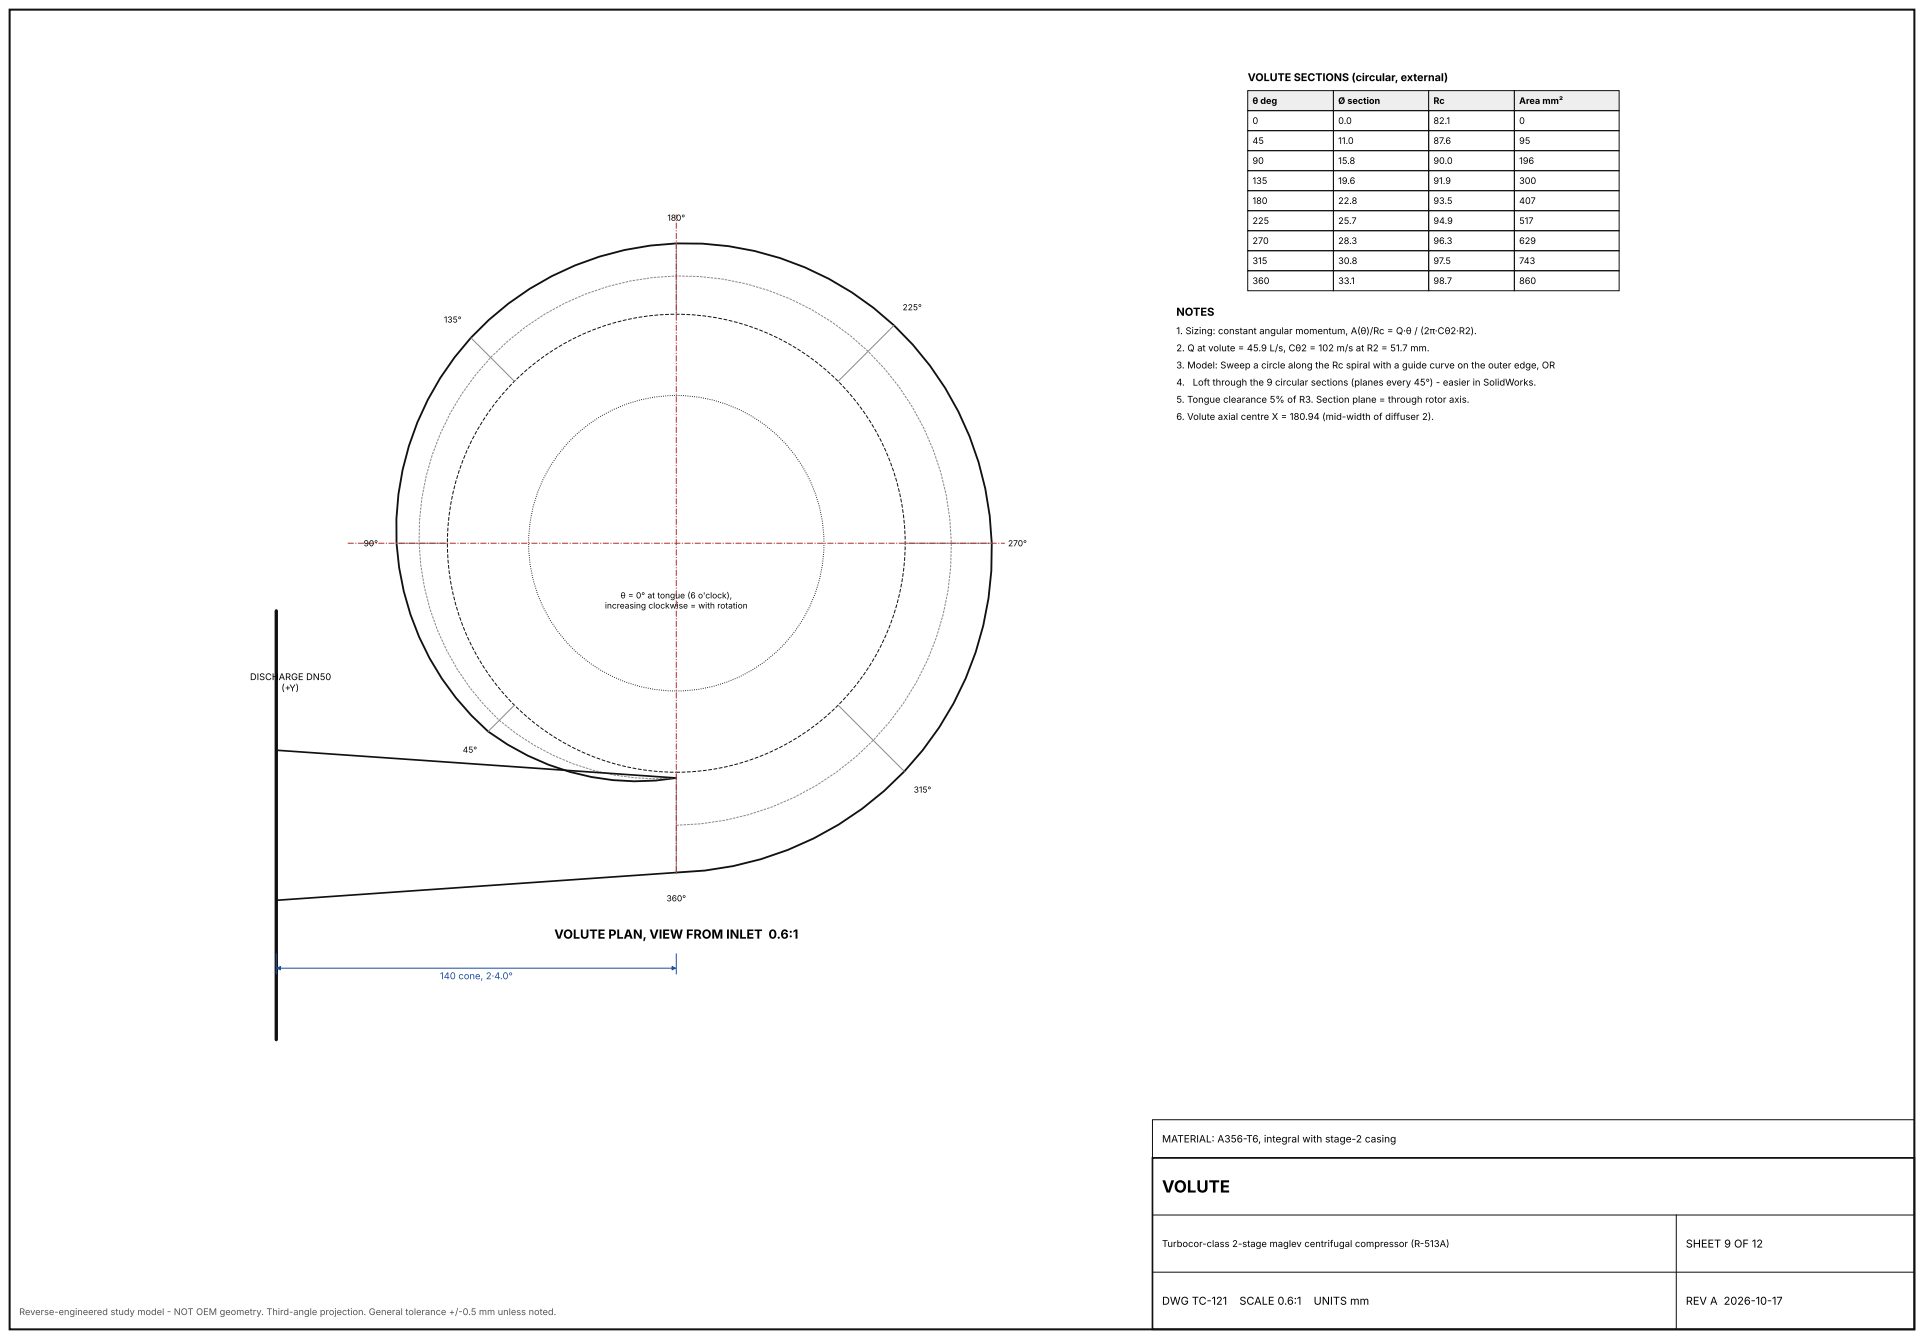
[picture p36: page 9]
VOLUTE; SHEET 9 OF 12; θ deg; Ø section; Area mm²; 140 cone, 2·4.0°; DISCHARGE DN50 (+Y)

VOLUTE SECTIONS (circular, external)

NOTES
1. Sizing: constant angular momentum, A(θ)/Rc = Q·θ / (2π·Cθ2·R2).
2. Q at volute = 45.9 L/s, Cθ2 = 102 m/s at R2 = 51.7 mm.

3. Model: Sweep a circle along the Rc spiral with a guide curve on the outer edge, OR
4. Loft through the 9 circular sections (planes every 45°) - easier in SolidWorks.
5. Tongue clearance 5% of R3. Section plane = through rotor axis.
6. Volute axial centre X = 180.94 (mid-width of diffuser 2).

θ = 0° at tongue (6 o'clock),
increasing clockwise = with rotation

VOLUTE PLAN, VIEW FROM INLET 0.6:1

MATERIAL: A356-T6, integral with stage-2 casing

Turbocor-class 2-stage maglev centrifugal compressor (R-513A)

DWG TC-121 SCALE 0.6:1 UNITS mm

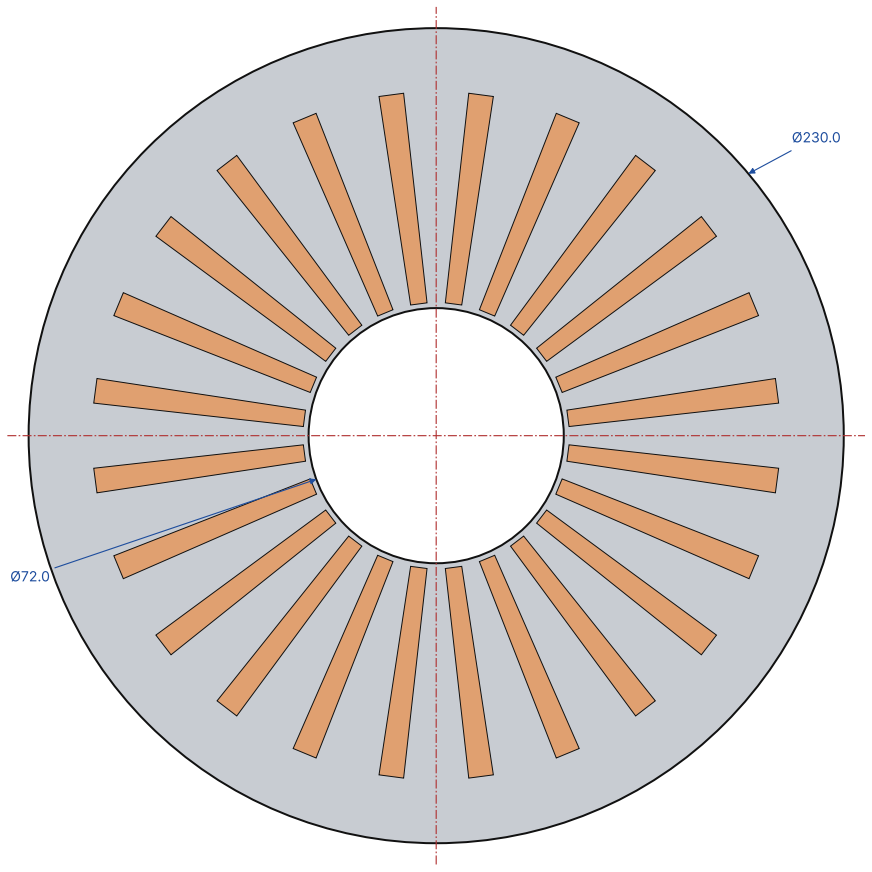
[picture p37: figure]

# MOTOR STATOR & HOUSING

Turbocor-class 2-stage maglev centrifugal compressor (R-513A)

DWG TC-130 SCALE 1:3 / 1:2 UNITS mm

SHEET 10 OF 12

MATERIAL: Housing A356-T6 / ductile iron; stator 0.2 mm NO20 laminations; Cu Litz windings

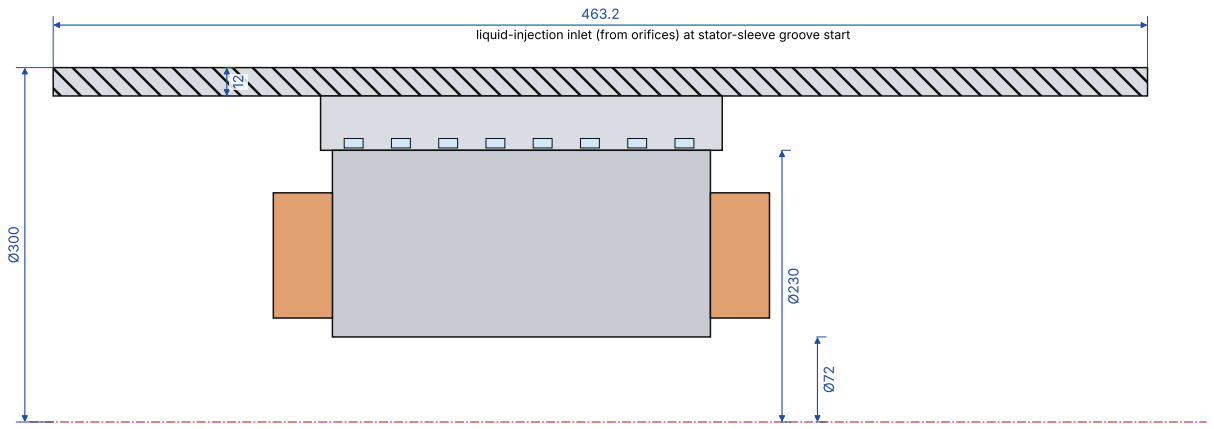
[picture p38: figure]

### HOUSING SECTION 1:3

### STATOR LAMINATION 1:2

NOTES
1. Rated ~113 kW at 30,000 rpm (36 N.m); 500 Hz electrical at 30k rpm (2-pole).
2. Air gap 1 mm to CFRP sleeve (rotor Ø70 over sleeve, stator bore Ø72).
3. Housing: revolve the section, cut helical groove with Swept Cut (Helix/Spiral, pitch 20).
4. Stator stack is press-fit into the groove sleeve; end windings modelled as simple rings.
5. Motor cavity is vented to suction - for CFD this region is NOT in the main gas path.

160 STACK

liquid-injection inlet (from orifices) at stator-sleeve groove start

24 slots, 3-phase, 2-pole, 1 mm slot opening

Helical cooling groove 8w x 4d, pitch 20

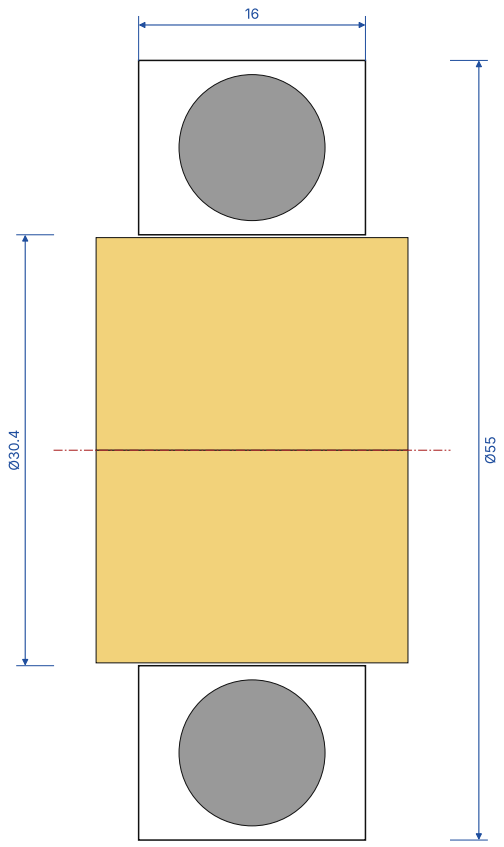
[picture p39: figure]

# MAGNETIC & TOUCHDOWN BEARINGS

Turbocor-class 2-stage maglev centrifugal compressor (R-513A)

DWG TC-140 SCALE 0.7:1 / 1:1 / 2:1 UNITS mm

SHEET 11 OF 12

MATERIAL: Stators: laminated Si-steel (radial), solid Co-Fe / low-C steel (axial); Cu coils

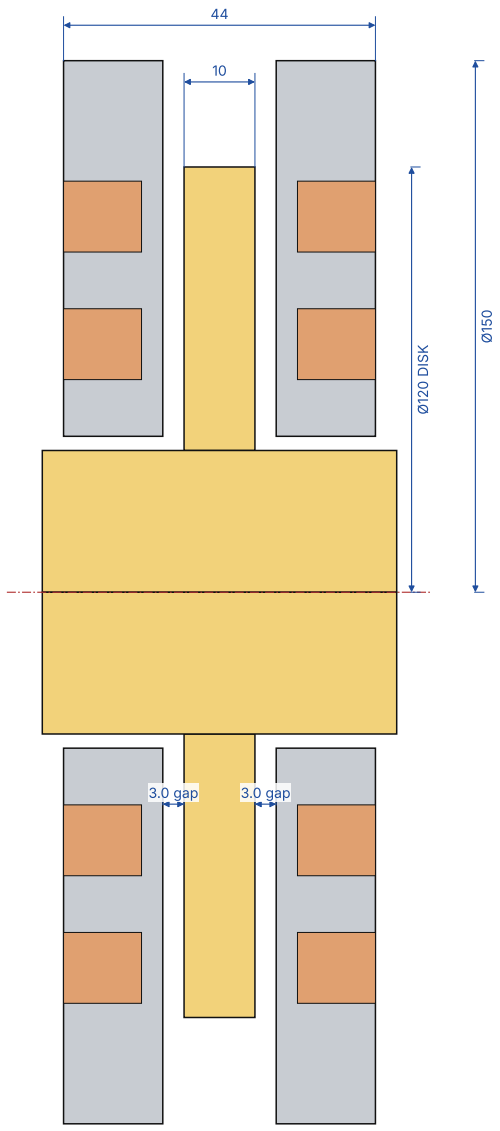
[picture p40: figure]
3.0 gap; Ø120 DISK

### AXIAL BEARING SECTION 1:1

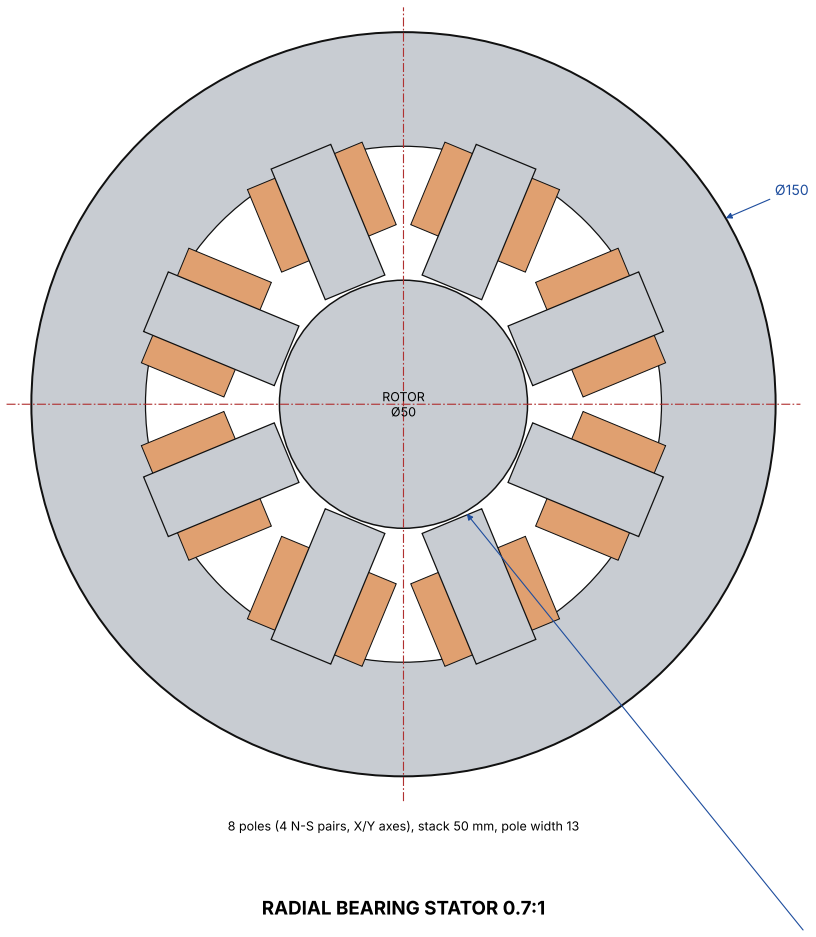
[picture p41: figure]
RADIAL BEARING STATOR 0.7:1; ROTOR Ø50

### TOUCHDOWN BEARING 2:1

NOTES

1. Bearings are electromagnets - for CAD model laminations/coils as simple solids.
2. Radial: 0.5 mm air gap; touchdown (ceramic hybrid angular-contact pair): 0.2 mm radial
3. clearance, so the rotor lands on touchdowns before touching magnetic poles.
4. Axial: two stators straddle the thrust disk, 0.5 mm nominal gap each side.
5. Position sensors (eddy-current) sit next to each radial bearing and at the shaft end.

8 poles (4 N-S pairs, X/Y axes), stack 50 mm, pole width 13

Ø51 POLE BORE (0.5 mm gap)

# CFD FLUID DOMAINS & BOUNDARY CONDITIONS

Turbocor-class 2-stage maglev centrifugal compressor (R-513A) | SHEET 12 OF 12

DWG CFD-001 SCALE 1.6:1 UNITS mm

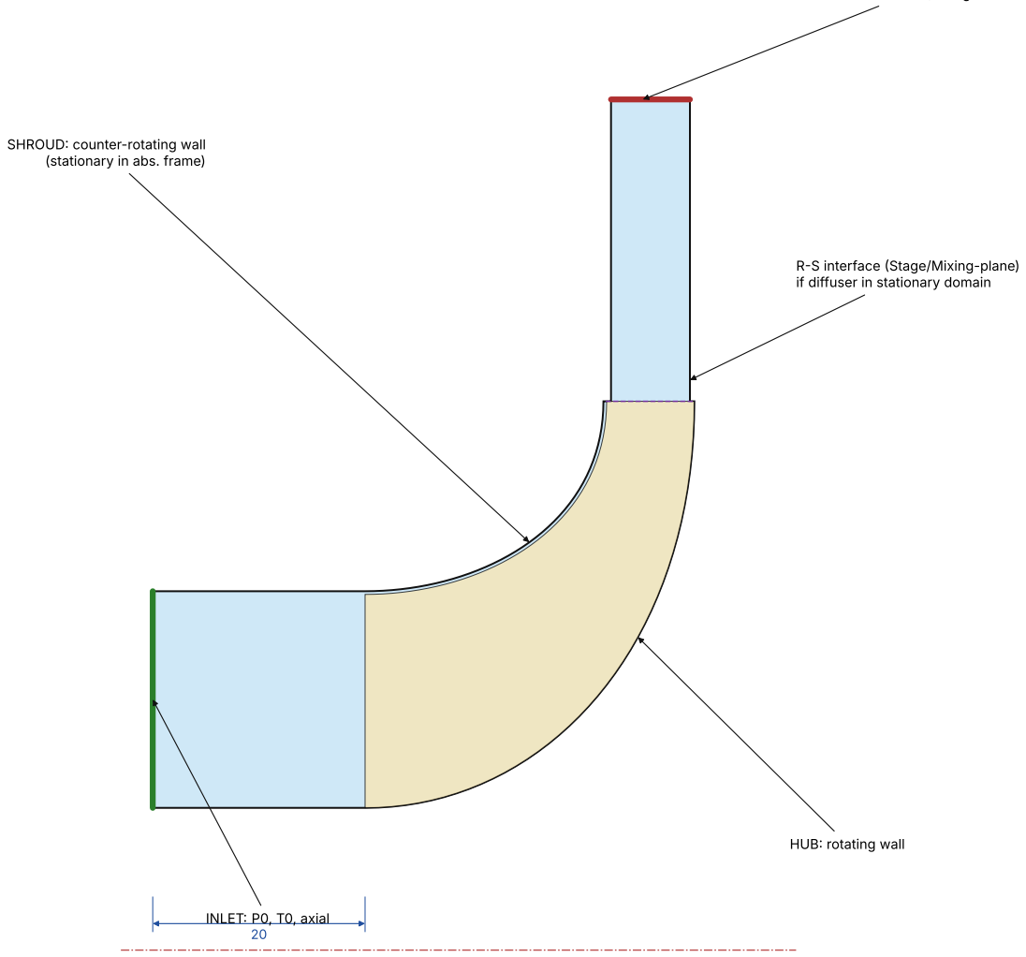
[picture p42: figure]
INLET: P0, T0, axial; R-S interface (Stage/Mixing-plane); if diffuser in stationary domain; SHROUD: counter-rotating wall (stationary in abs. frame); HUB: rotating wall

### DOMAIN A: STAGE-1 SINGLE PASSAGE (TurboGrid -> CFX) 1.6:1

DOMAIN A SETUP

Item | Setting
Mass flow (full wheel) | 3.343 kg/s
Per passage (7 main+splitter) | 0.4776 kg/s
Inlet P0 / T0 | 364.3 kPa / 279.65 K
Rotation | 30,000 rpm about +X
Periodicity | 360/7 = 51.43 deg rotational
Tip clearance | 0.3 mm at shroud
Turbulence | SST k-ω, y+ ~1 on blades
Fluid | R-513A real gas (RGP / Peng-Robinson)
Expected stage-1 PR | ~1.98 (meanline)

NOTES
1. DOMAIN B (full-stage / 360 deg, Fluent or CFX): extract the fluid volume of the assembly
2. (SpaceClaim Volume Extract) from suction flange to discharge flange, rotor stationary
3. domains split at impeller inlet/outlet; Frozen Rotor interfaces; ~10-20 M cells.
4. Run DOMAIN A first (minutes-hours on a workstation); B only once A is converged and sane.
5. Do NOT mesh the motor, bearings, or electronics for the aero CFD.
6. Speed lines: vary back-pressure/mass flow at 24k, 27k, 30k, 33k rpm to map surge/choke.
7. Post: PR_tt, η_tt (from h0 or T0/P0 with real gas), blade loading, Mach number at 50% span.

OUTLET: mass flow (or avg static P)
