drewarney/Turbocore-Maglev-Compressor-analysis/cad_curves/flowpath/README.txt

Meridional flow-path pieces (machine coordinates: X along the axis, r = Y, Z = 0).
Sketch on the FRONT plane. Easiest: import the DXFs in ../profiles instead.

Curves (Insert > Curve > Curve Through XYZ Points, one file each):
  S1_inlet_contraction.txt
  S2_stage1_shroud.txt
  S3_crossover_outer_arc.txt
  S4_return_to_eye2_shroud.txt
  S5_stage2_shroud.txt
  H1_nose.txt
  H2_stage1_hub.txt
  H3_crossover_inner_arc.txt
  H4_return_to_eye2_hub.txt
  H5_stage2_hub.txt

Straight walls (draw as sketch lines, X r in mm):
  S0 inlet straight                (0.000, 51.000) -> (70.000, 51.000)
  S2->diffuser-1 shroud            (117.453, 51.686) -> (118.166, 51.686)
  diffuser-1 shroud wall           (118.166, 51.686) -> (118.166, 80.113)
  return channel downstream wall   (141.032, 80.113) -> (141.032, 46.000)
  S5->diffuser-2 shroud            (178.538, 51.686) -> (179.048, 51.686)
  diffuser-2 shroud wall           (179.048, 51.686) -> (179.048, 80.113)
  H2->diffuser-1 hub               (126.012, 51.686) -> (125.599, 51.686)
  diffuser-1 hub wall              (125.599, 51.686) -> (125.599, 80.113)
  return channel upstream wall     (133.599, 80.113) -> (133.599, 40.000)
  H5->diffuser-2 hub               (183.043, 51.686) -> (182.833, 51.686)
  diffuser-2 hub wall              (182.833, 51.686) -> (182.833, 80.113)
