drewarney/Turbocore-Maglev-Compressor-analysis/drawings/impeller1_expected_render.png

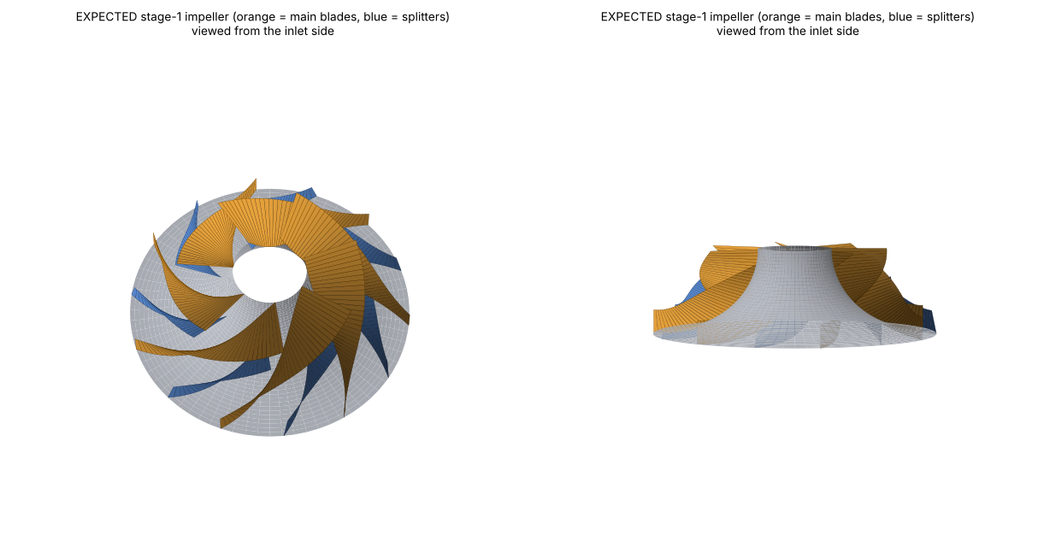
drawings/impeller1_expected_render.png
