drewarney/Turbocore-Maglev-Compressor-analysis/drawings/MFG-101.png

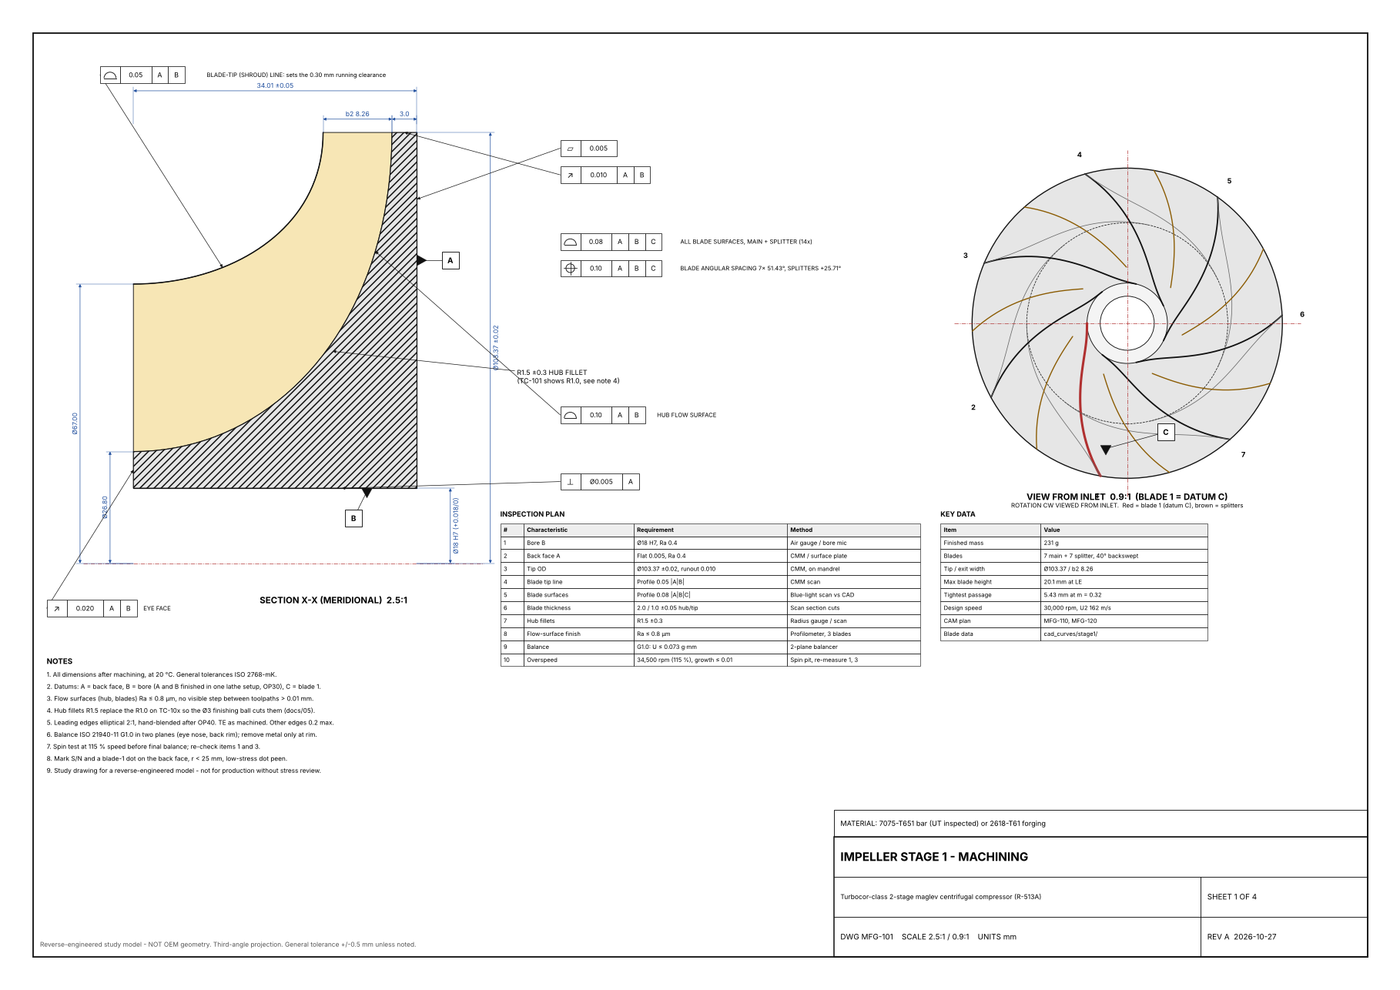
drawings/MFG-101.png
