drewarney/Turbocore-Maglev-Compressor-analysis/drawings/MFG-110.png

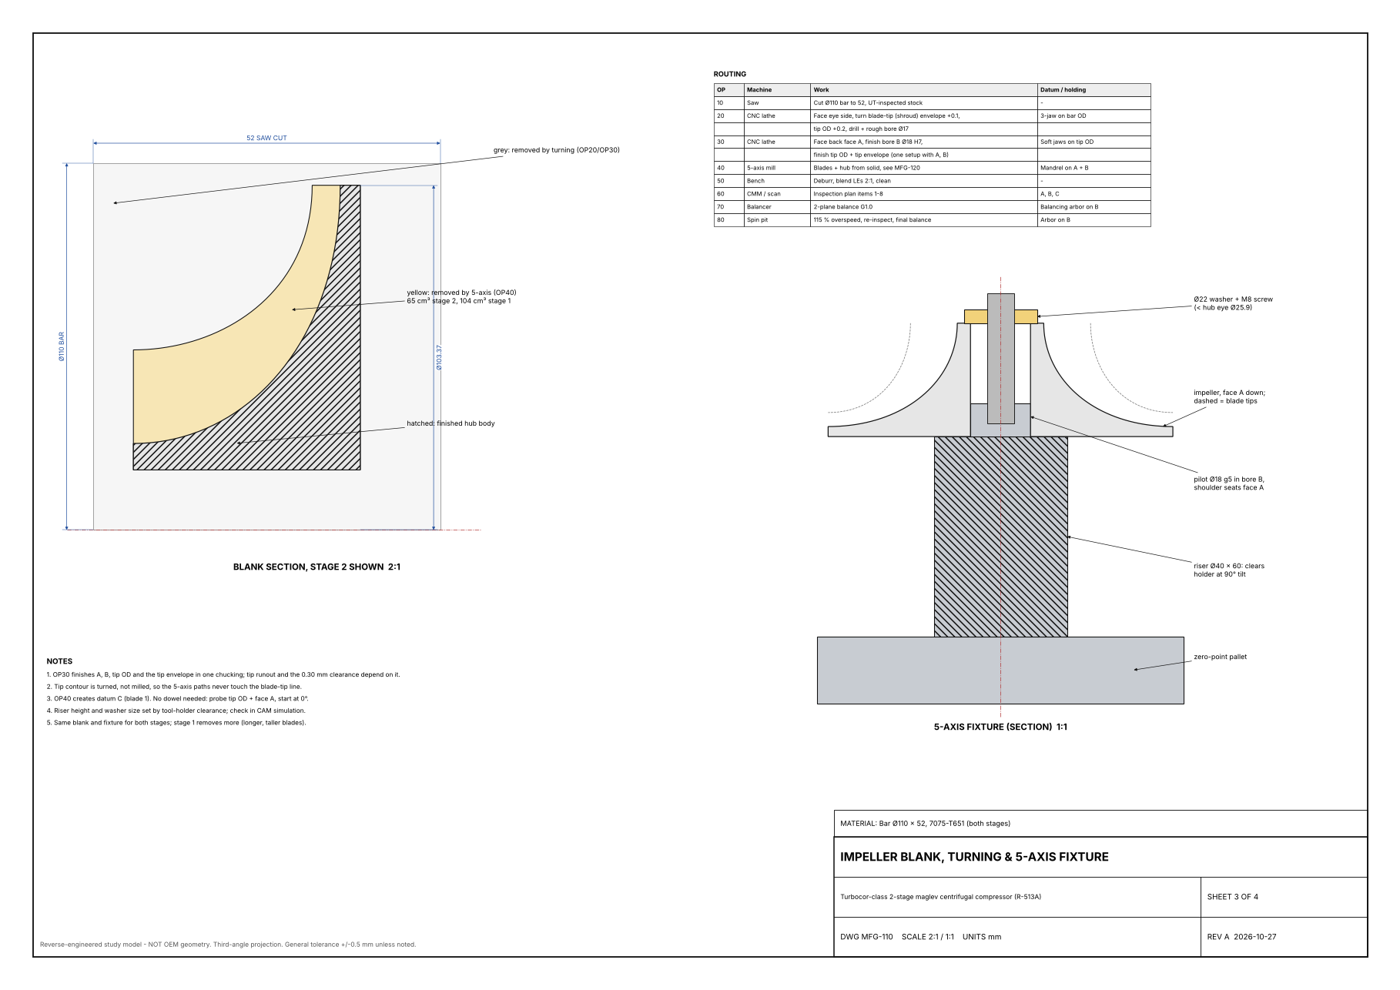
drawings/MFG-110.png
