drewarney/Turbocore-Maglev-Compressor-analysis/drawings/MFG-120.png

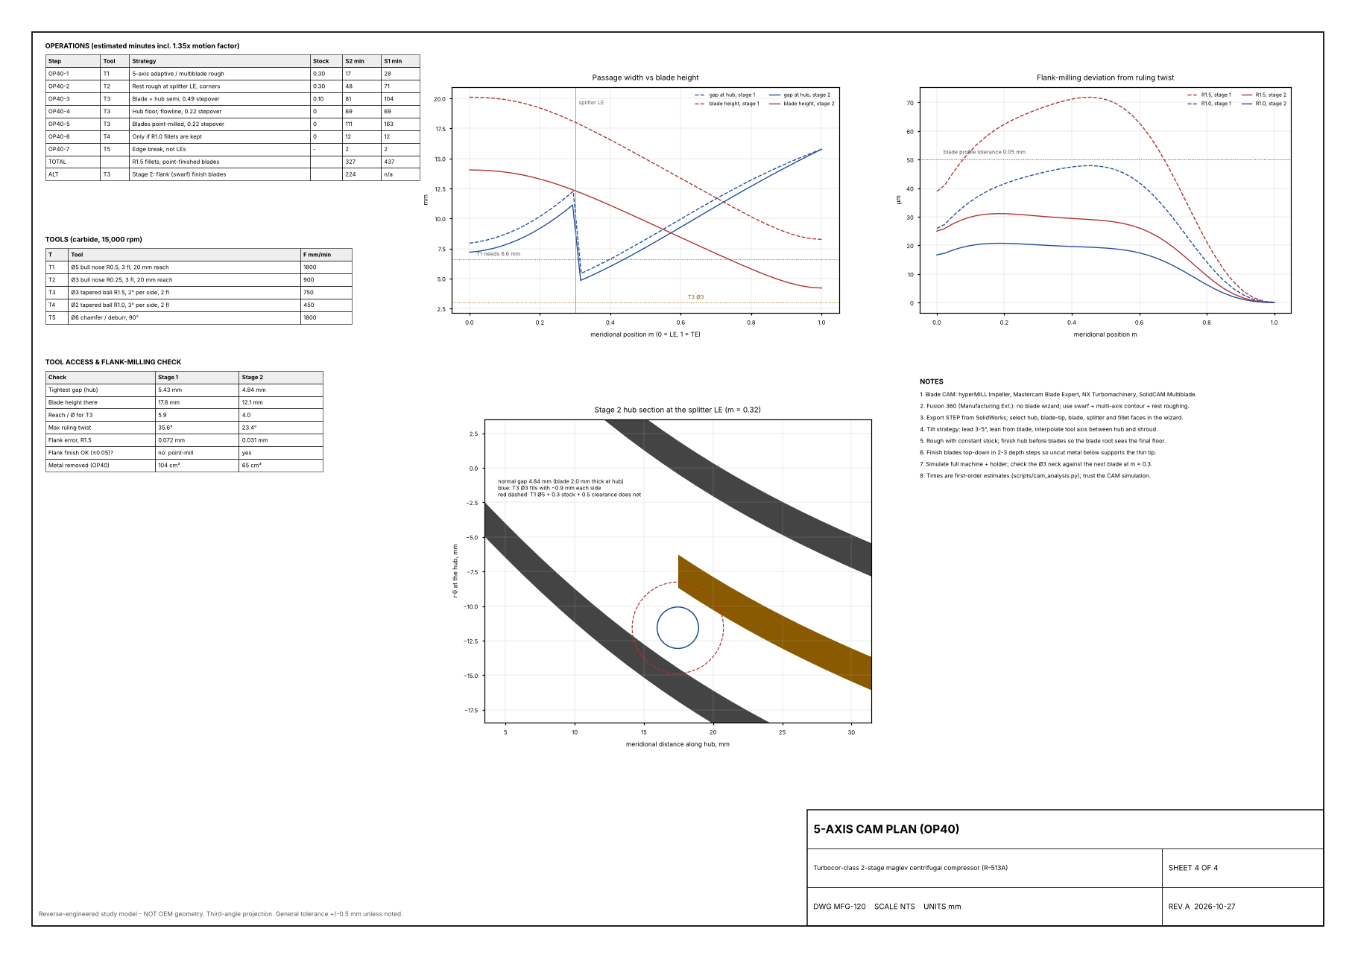
drawings/MFG-120.png
