drewarney/Turbocore-Maglev-Compressor-analysis/drawings/SK-001_impeller_mounting.png

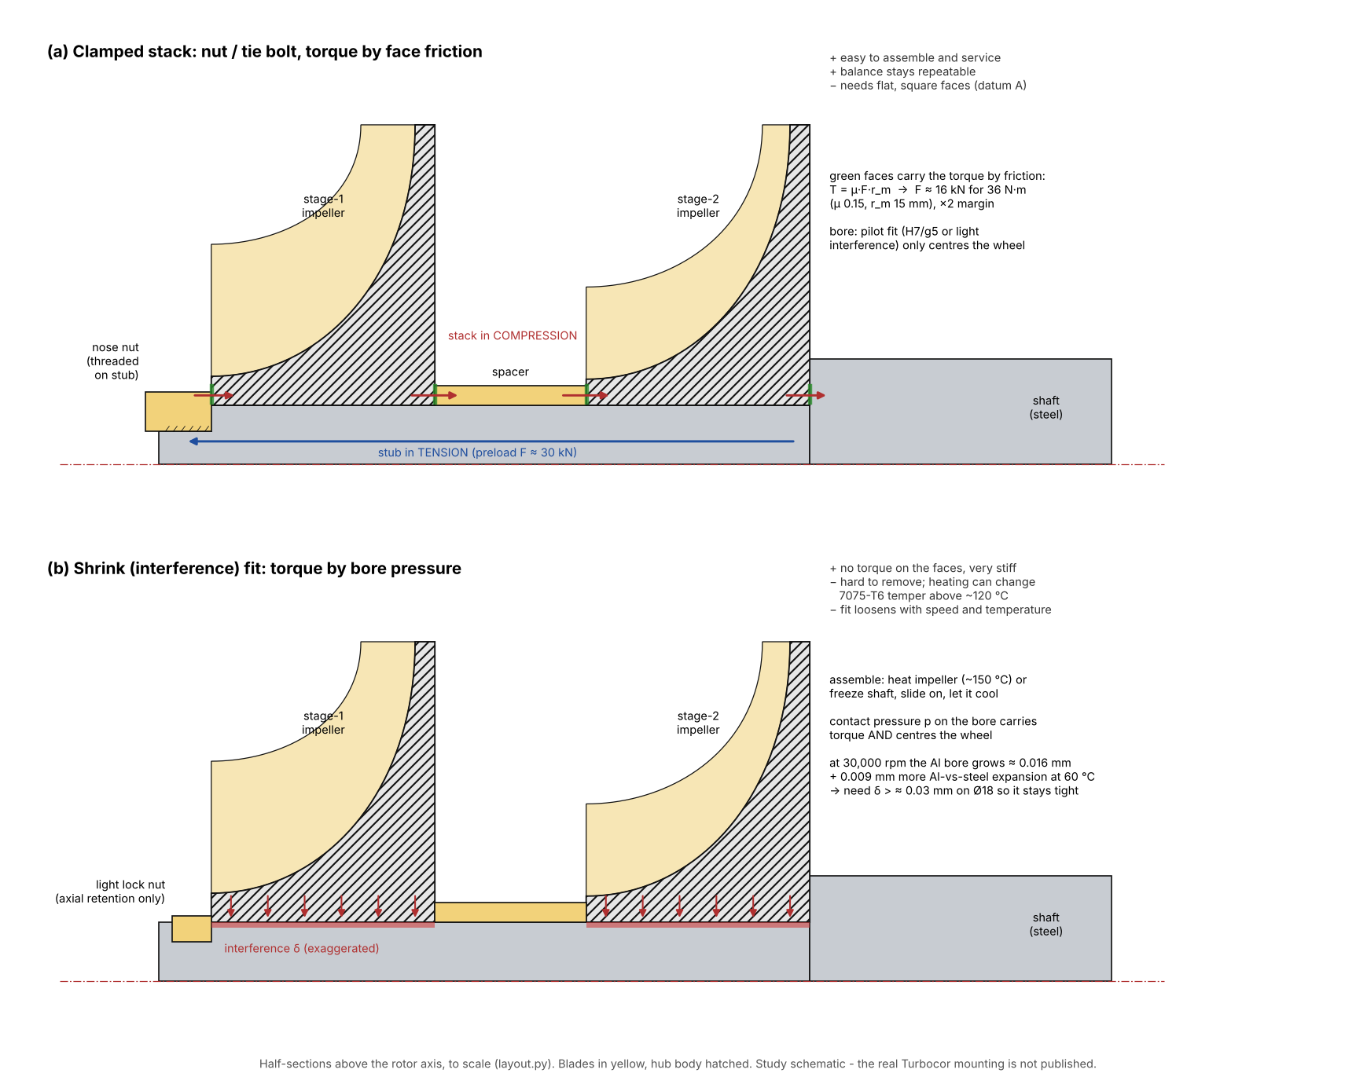
drawings/SK-001_impeller_mounting.png
