drewarney/Turbocore-Maglev-Compressor-analysis/drawings/TC-000.png

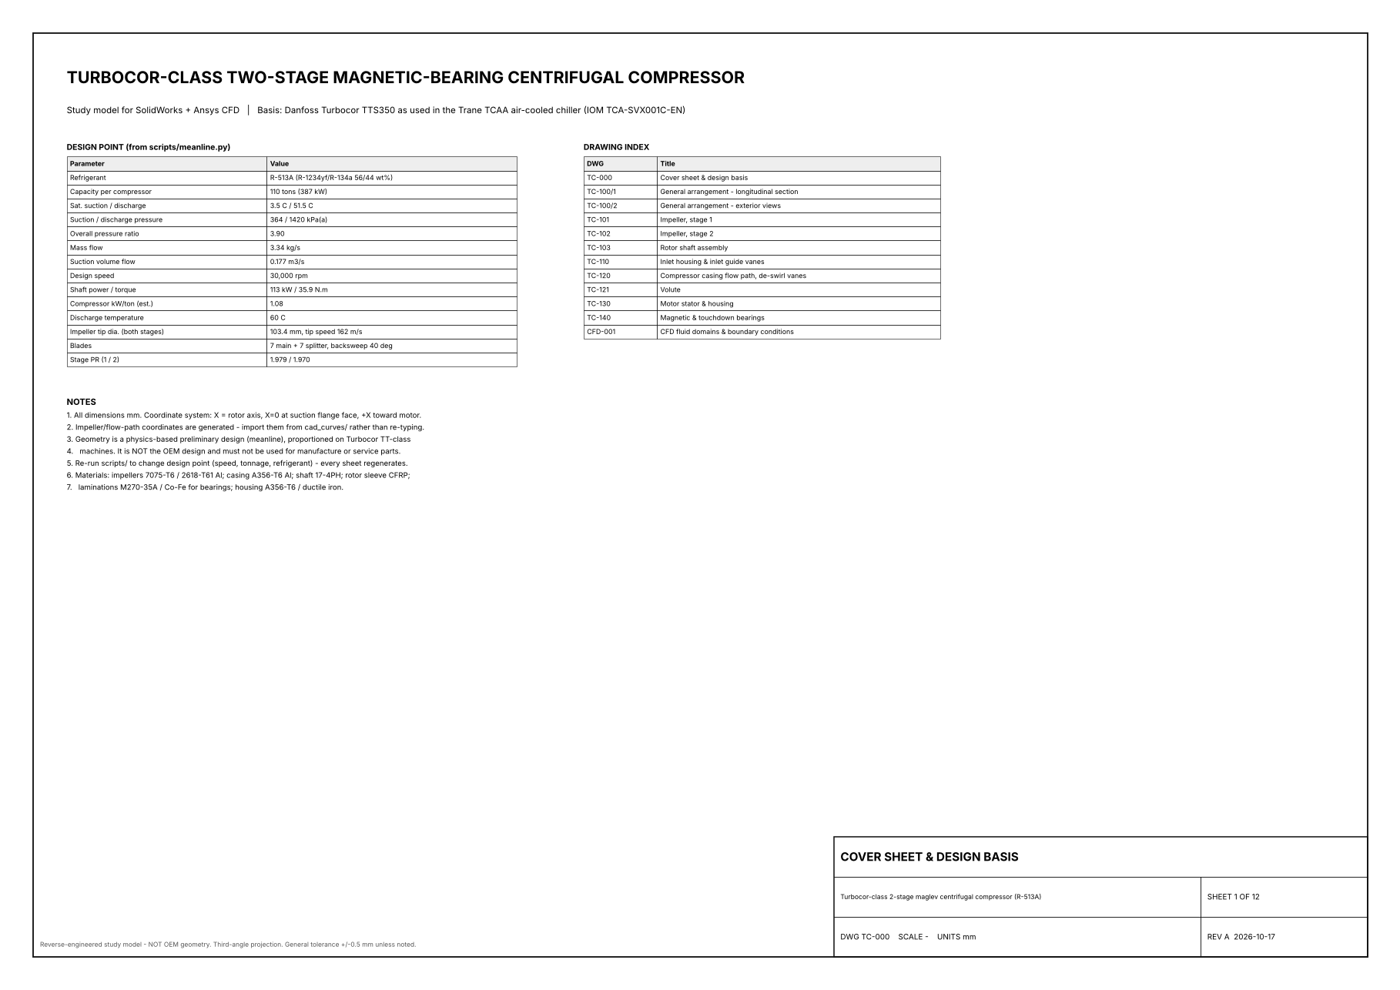
drawings/TC-000.png
