drewarney/Turbocore-Maglev-Compressor-analysis/drawings/TC-100-2.png

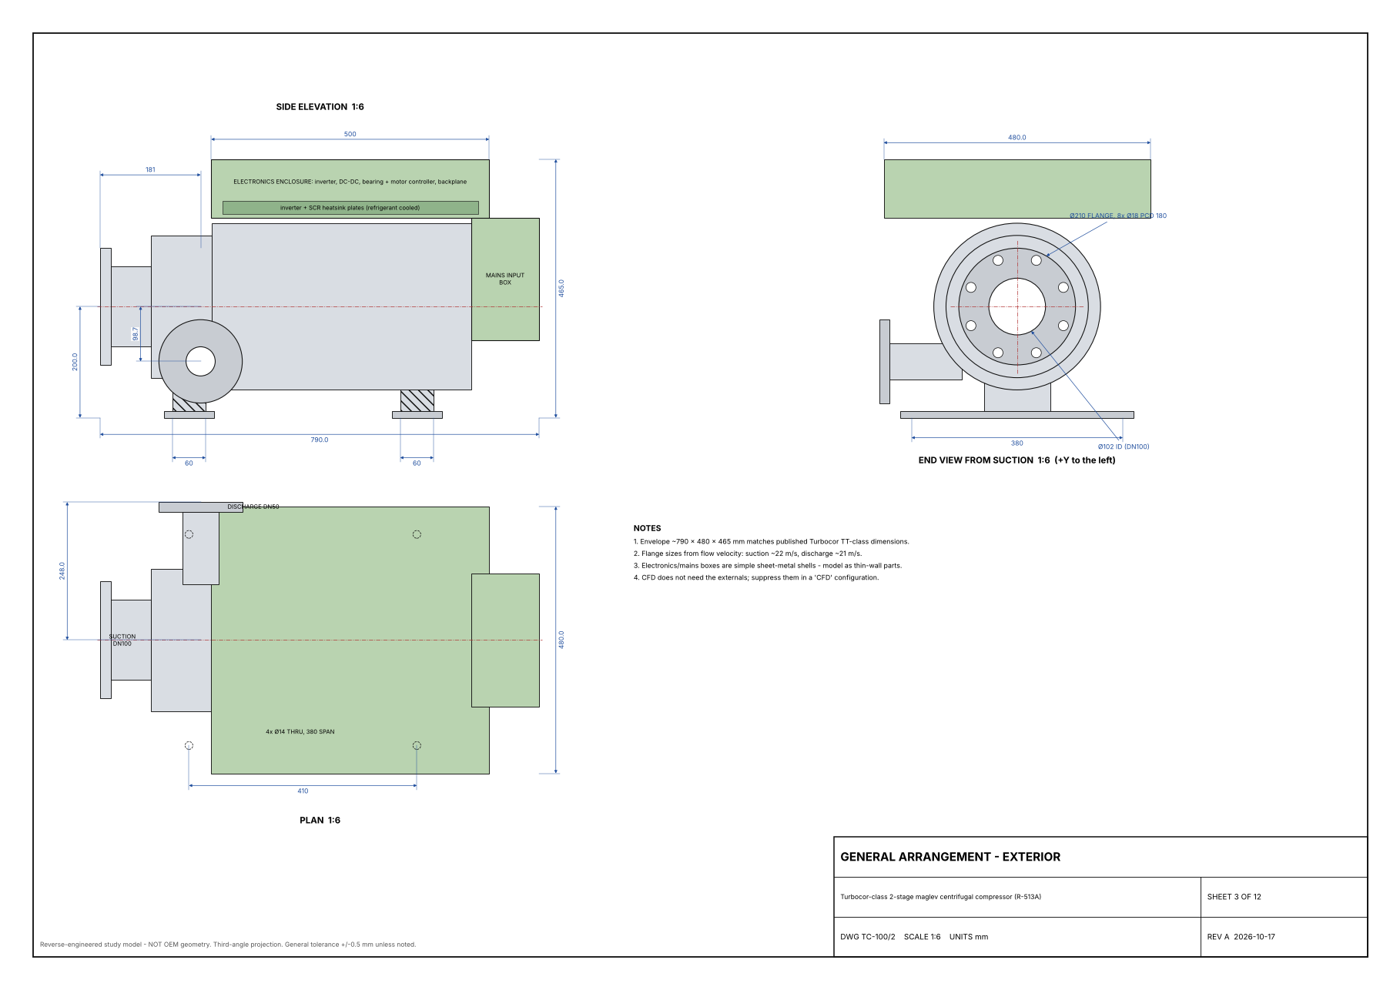
drawings/TC-100-2.png
