drewarney/Turbocore-Maglev-Compressor-analysis/drawings/TC-103.png

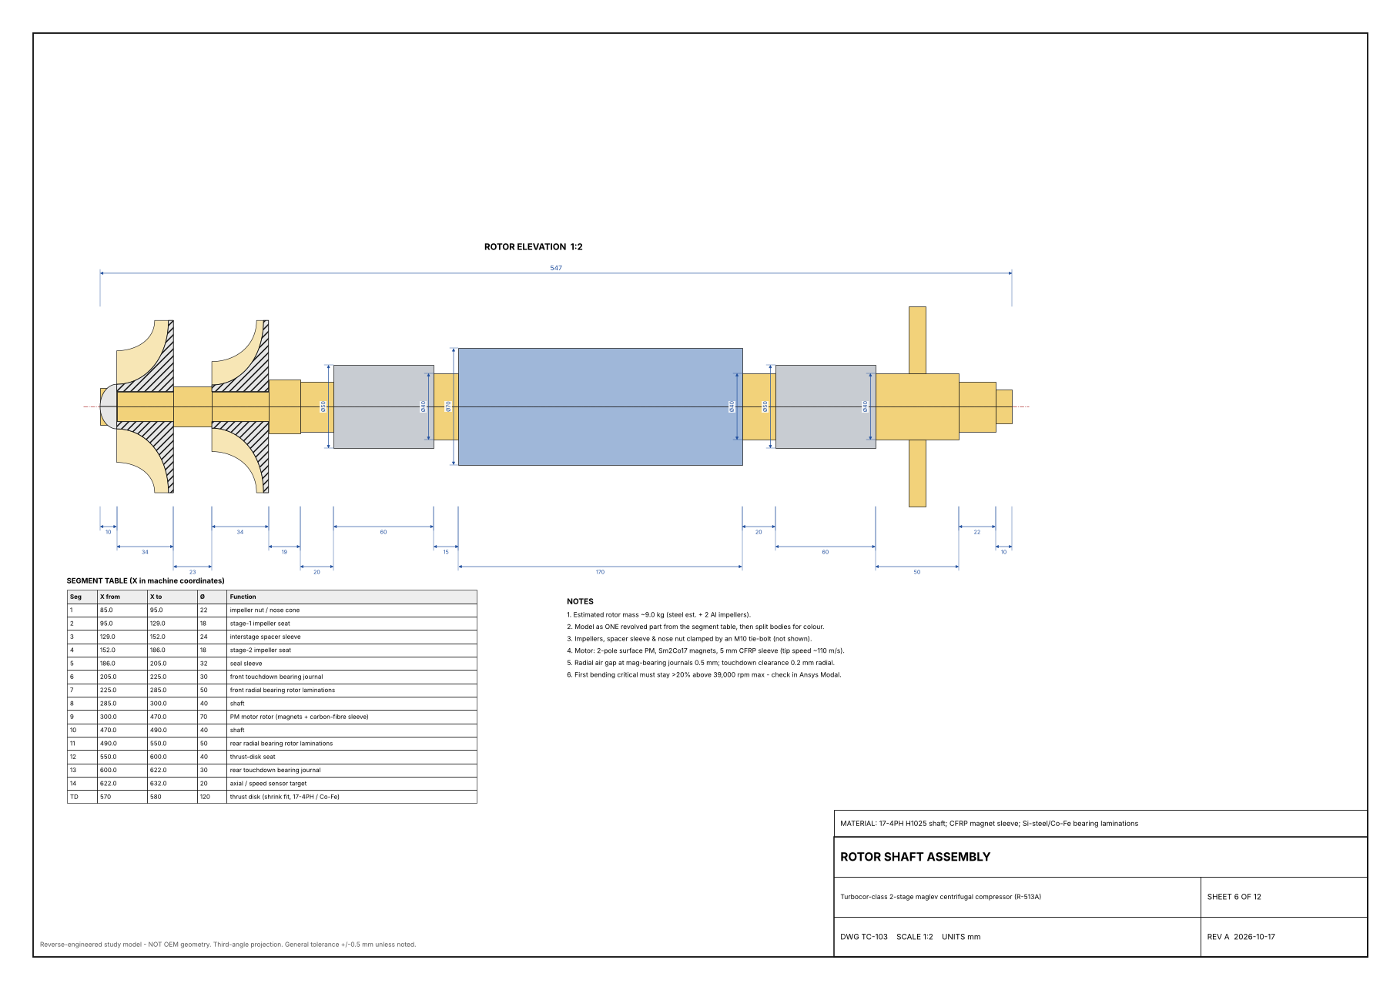
drawings/TC-103.png
