drewarney/Turbocore-Maglev-Compressor-analysis/drawings/TC-110.png

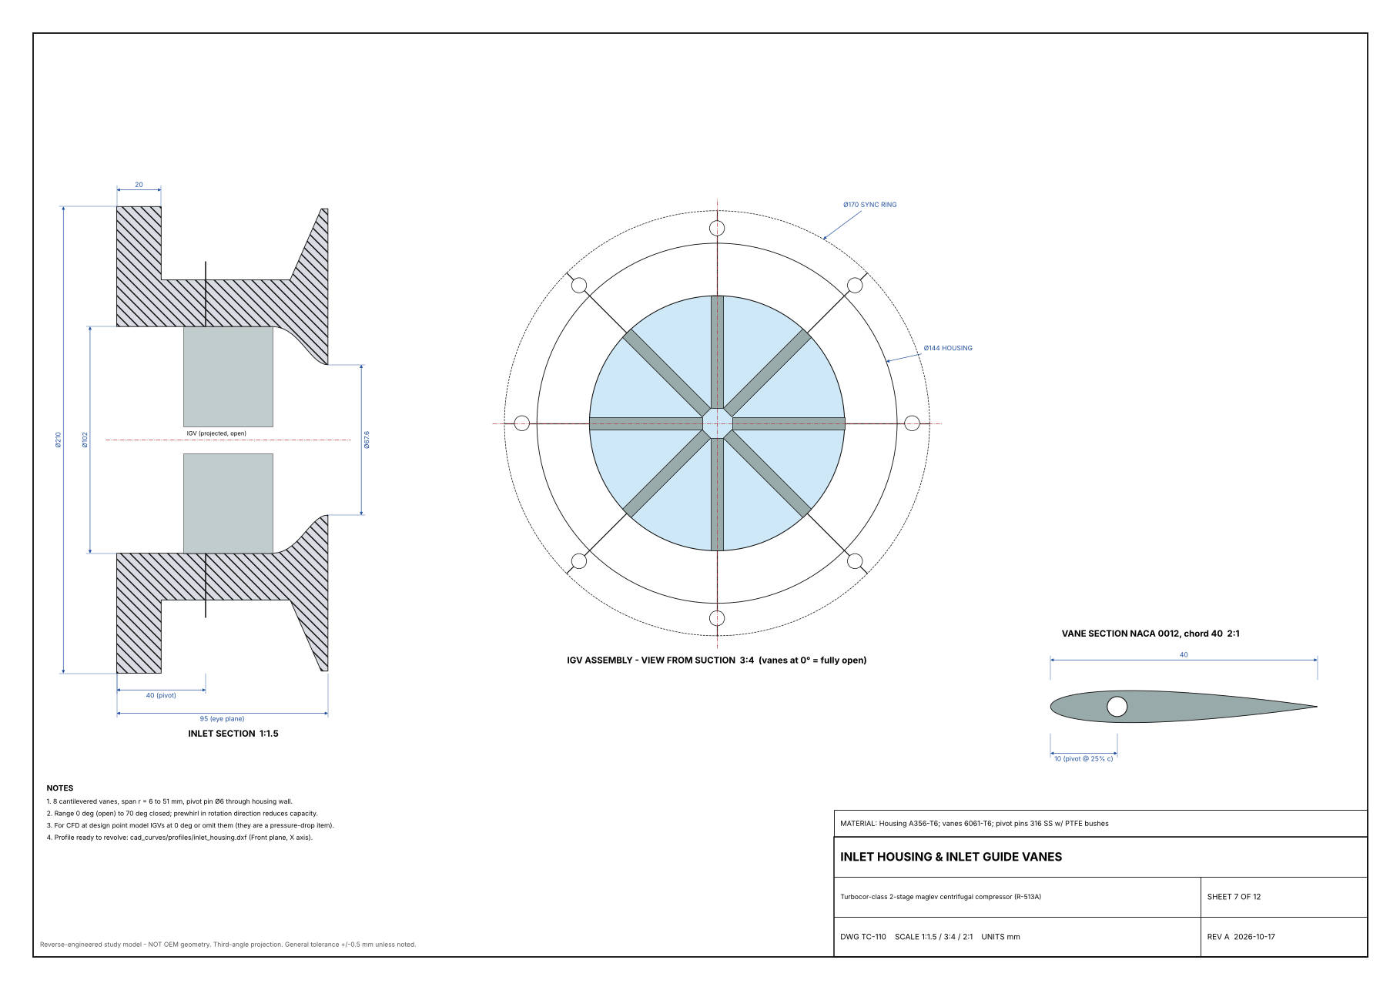
drawings/TC-110.png
