drewarney/Turbocore-Maglev-Compressor-analysis/drawings/TC-120.png

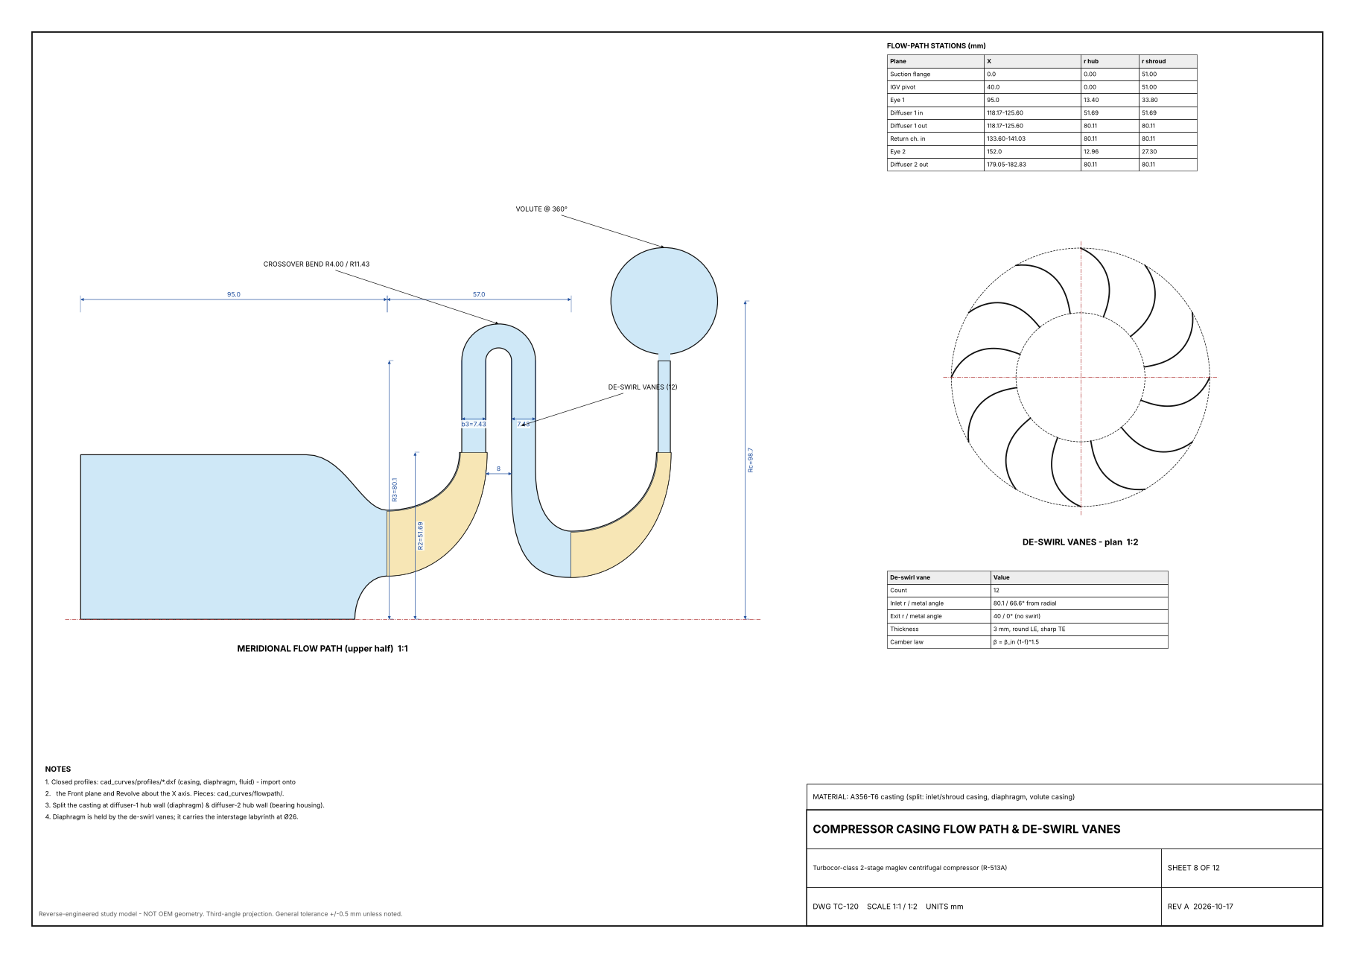
drawings/TC-120.png
