drewarney/Turbocore-Maglev-Compressor-analysis/drawings/TC-121.png

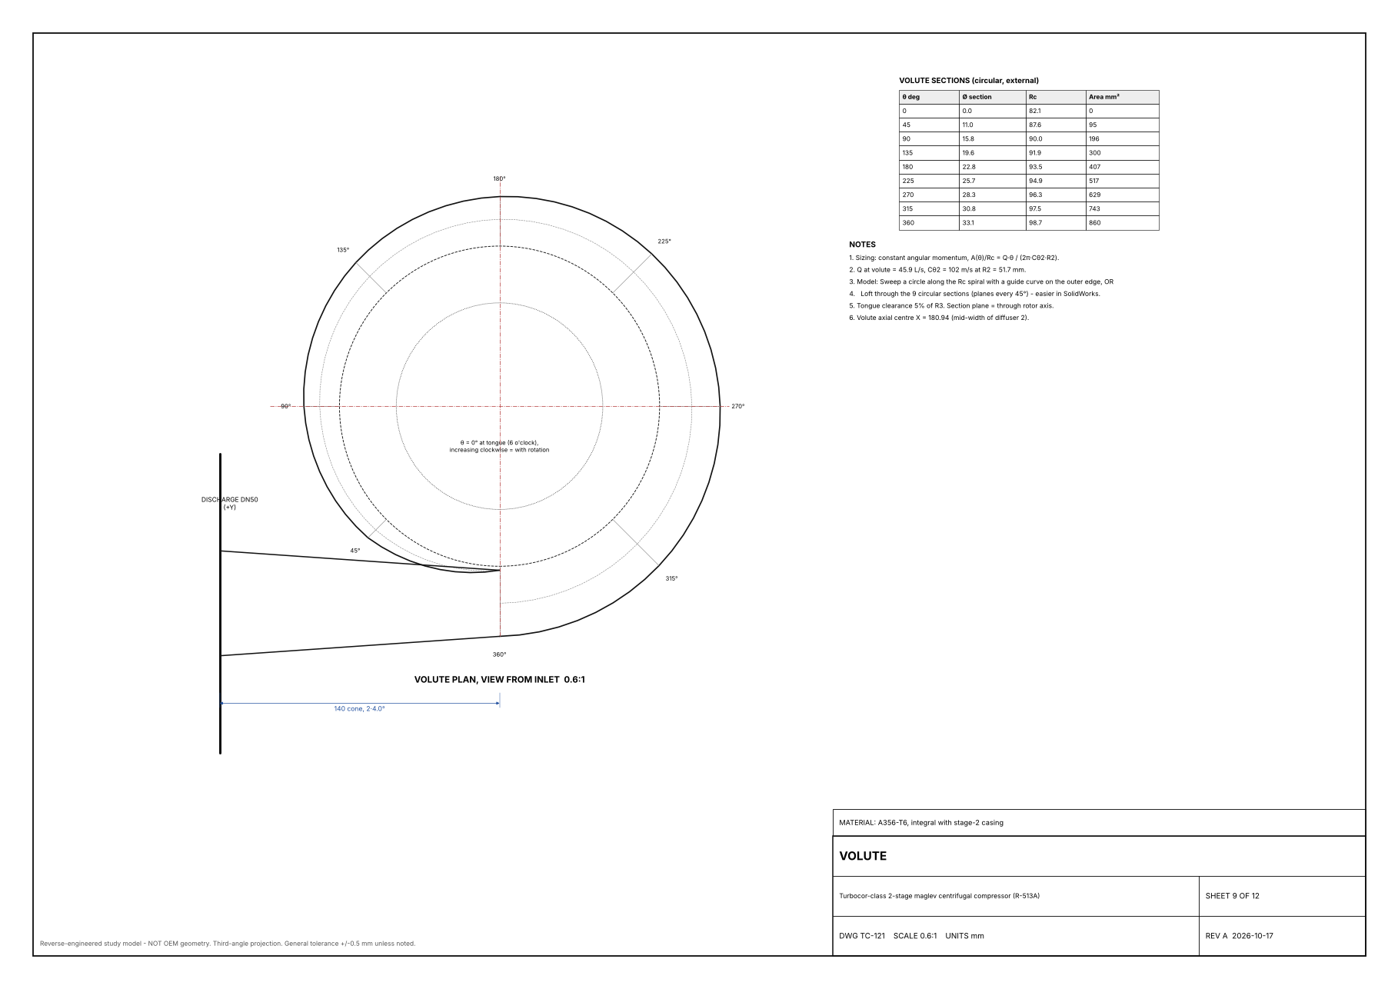
drawings/TC-121.png
