drewarney/Turbocore-Maglev-Compressor-analysis/drawings/TC-130.png

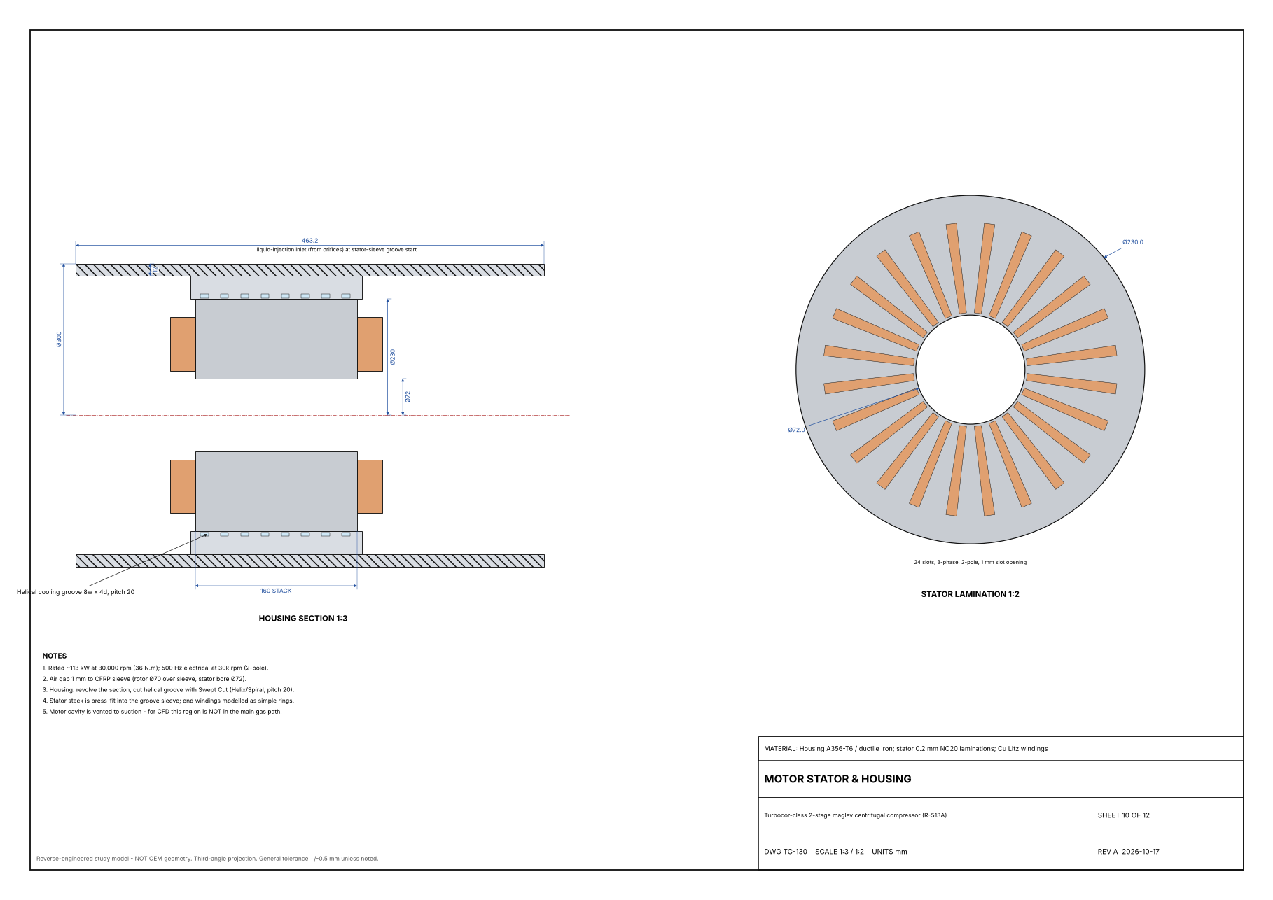
drawings/TC-130.png
