drewarney/Turbocore-Maglev-Compressor-analysis/drawings/TC-140.png

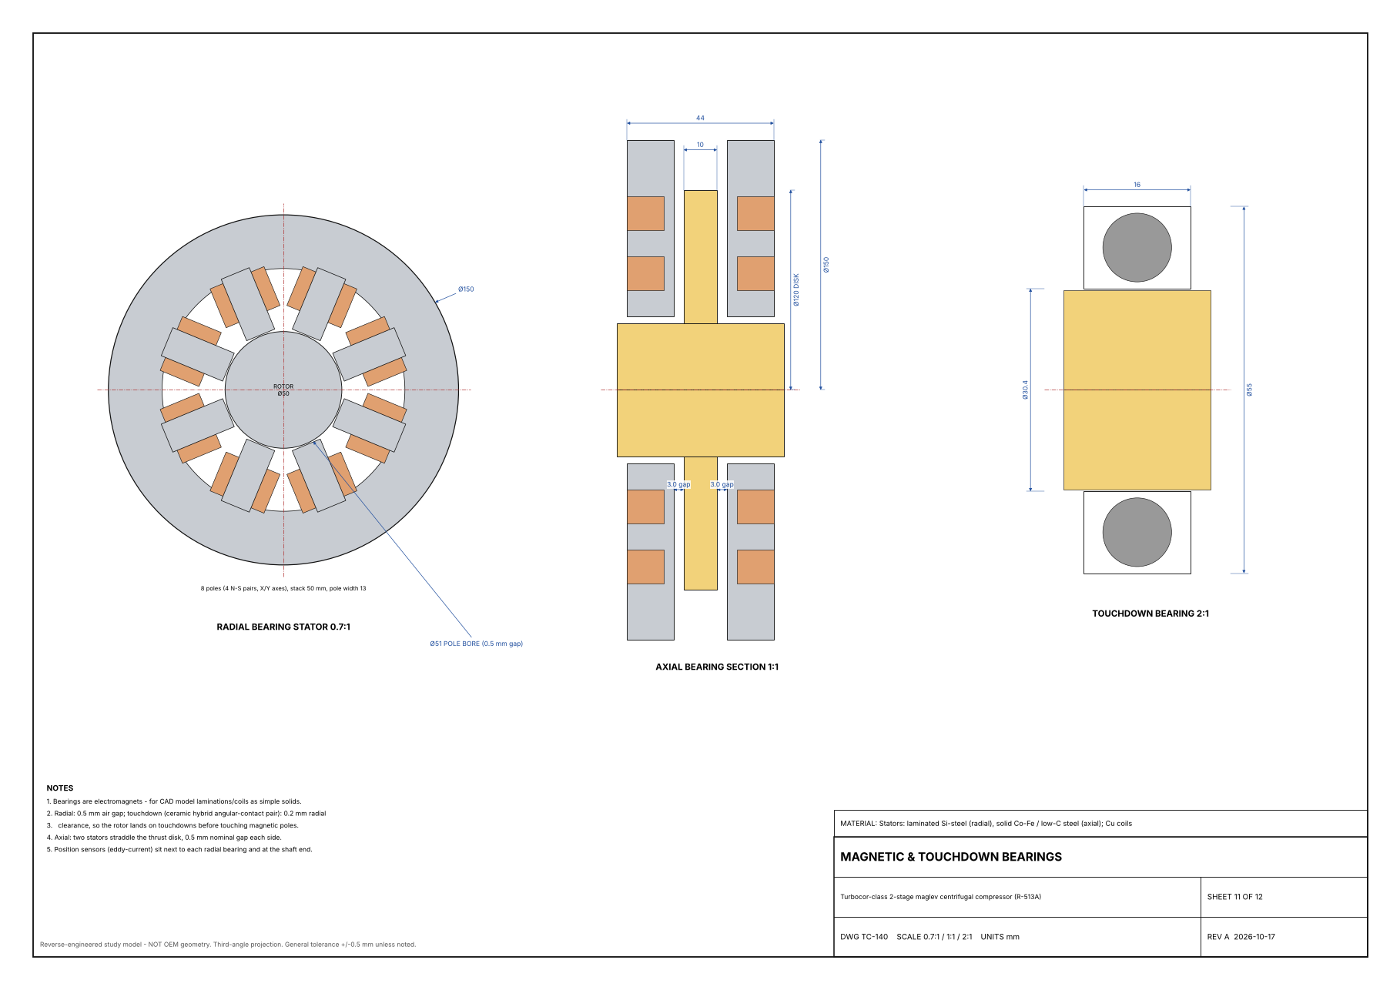
drawings/TC-140.png
