drewarney/Turbocore-Maglev-Compressor-analysis/cad_curves/profiles/fluid_domain.dxf

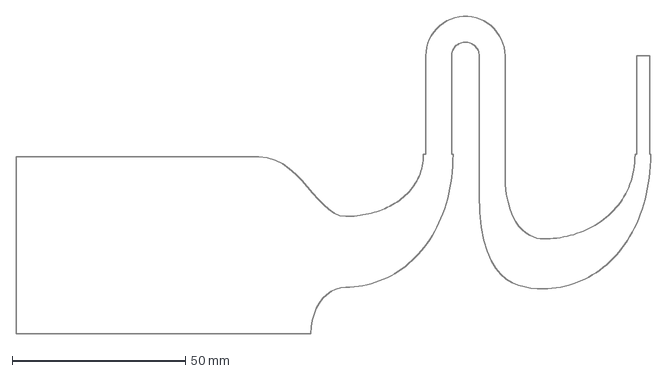
[picture p56: CAD file, 2026-10-17]
cad_curves/profiles/fluid_domain.dxf
183.0 x 91.5 mm
