drewarney/Turbocore-Maglev-Compressor-analysis/cad_curves/profiles/flowpath_walls.dxf

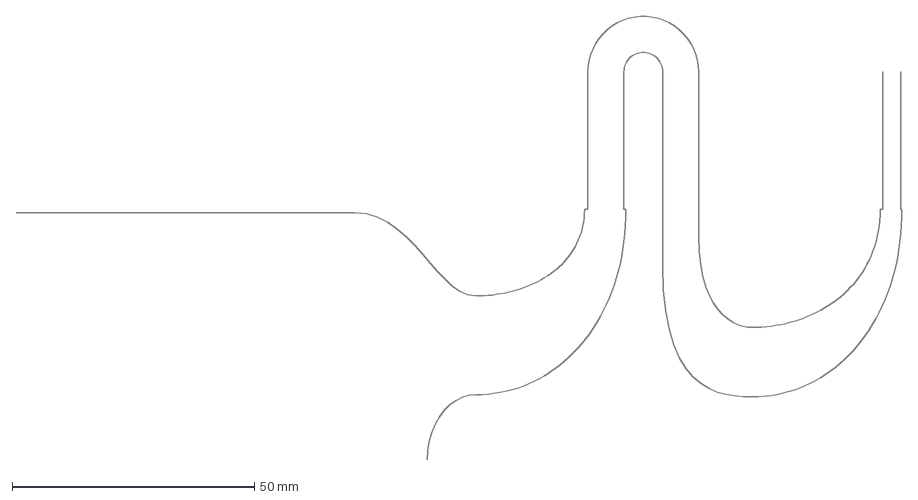
[picture p57: CAD file, 2026-10-17]
cad_curves/profiles/flowpath_walls.dxf
183.0 x 91.5 mm
