drewarney/Turbocore-Maglev-Compressor-analysis/cad_curves/profiles/compressor_casing.dxf

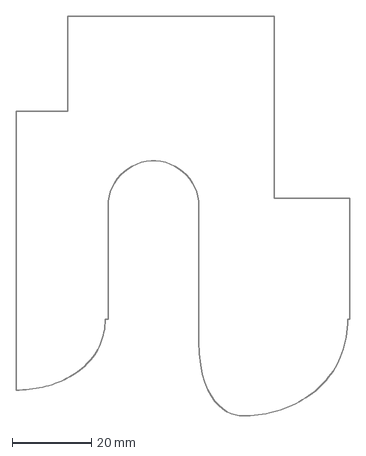
[picture p58: CAD file, 2026-10-17]
cad_curves/profiles/compressor_casing.dxf
84.0 x 100.7 mm
