drewarney/Turbocore-Maglev-Compressor-analysis/cad_curves/profiles/inlet_housing.dxf

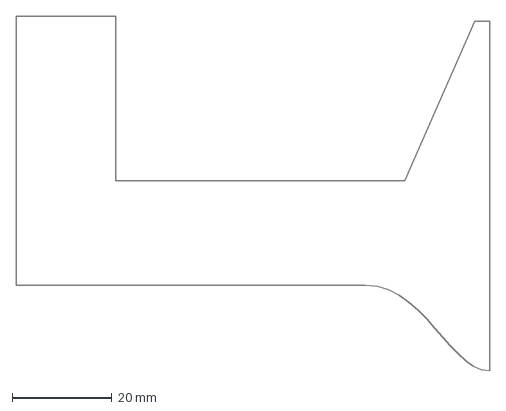
[picture p59: CAD file, 2026-10-17]
cad_curves/profiles/inlet_housing.dxf
95.0 x 71.2 mm
