drewarney/Turbocore-Maglev-Compressor-analysis/cad_curves/profiles/diaphragm.dxf

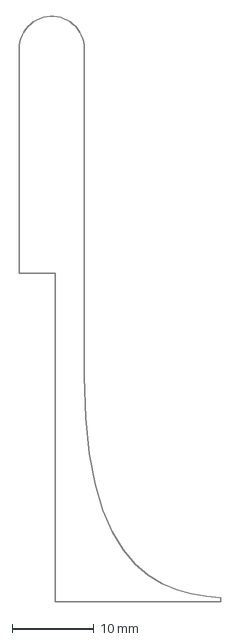
[picture p60: CAD file, 2026-10-17]
cad_curves/profiles/diaphragm.dxf
24.7 x 71.6 mm
