drewarney/Turbocore-Maglev-Compressor-analysis/(commit log)

2026-10-16 Turbocor-class maglev compressor study model: drawings, CAD curves, CFD guide
    Meanline design of a two-stage R-513A centrifugal compressor sized to the
    Trane TCAA air-cooled chiller duty (TTS350 class), generated impeller and
    flow-path curves for SolidWorks/TurboGrid, a 12-sheet dimensioned drawing
    set, and step-by-step SolidWorks build and Ansys CFD walkthroughs.
    Claude-Session: https://claude.ai/code/session_016brbCcfiQXCWtL22x14yQo
2026-10-16 Impeller build guide: mandatory blade trim cut and verification checklist
    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
2026-10-16 Build guide: trim cut also removes leading-edge stubs upstream of the eye
    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
2026-10-17 Fix flow-path curve import: clean segments and closed DXF profiles
    The combined flowpath_hub/shroud.txt files repeated a point at every segment
    join and mixed sharp corners into one spline, which SolidWorks' Curve Through
    XYZ Points rejects. Replace them with per-segment smooth curves (no duplicate
    points) and closed, ready-to-revolve DXF profiles for the inlet housing,
    compressor casing, diaphragm and fluid domain.
    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
2026-10-17 Casing shroud offset normal to the blade tips; guide builds casing sketches from XYZ curves
    The tip-clearance offset was applied along X only, leaving 0.3 mm gaps where
    the stage shroud curves meet the inlet contraction and return channel. Offset
    along the wall normal instead so every flow-path curve ends where the next
    begins. The build guide now walks through sketching the inlet housing, casing
    and diaphragm from the individual curves; DXF profiles stay as an optional
    shortcut.
    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
2026-10-21 TurboGrid inputs: full passage curves, casing as shroud, comment-free profiles
    hub/shroud curves now include a 20 mm inlet extension and the vaneless diffuser
    to R3, the shroud is the casing (blade tip + 0.3 mm) so TurboGrid cuts the tip
    gap correctly, and the profile files use bare '#Profile N' separators with no
    header comments.
    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
2026-10-21 CFD guide: add reference pressure back in the pressure-ratio monitor
    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
2026-10-24 Draft report (Word): design basis, CAD, CFD method, stage-1 off-design results
    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
2026-10-24 Add FBD/control-volume drawing set and hand-calculation package
    Eight free-body and control-volume diagrams (cycle, compressor CV, Euler CV,
    velocity triangles, rotating-frame particle, rotor radial and axial FBDs,
    rotating disc element) and a Word calc package (C1-C19) with Given / Find /
    Assumptions / Equations / Solution / Result for every sizing step, plus
    first-order estimates of bearing loads, unbalance, axial thrust, disc stress
    and critical speed, and the CFD post-processing calculations.
    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
2026-10-24 CFD guide: use T0 = 285 K for the R134a stand-in on stage 1
    At 364.26 kPa R-134a saturates at 279.33 K, so the R-513A suction
    temperature (279.65 K) leaves only 0.3 K superheat and the gas-only
    Peng-Robinson material condenses in the impeller eye. Pressure then
    collapses and PR/T0 fall to inlet values. 285 K keeps the flow dry.
    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
2026-10-24 CFD guide: correct expected stage-1 T0 out for the R134a stand-in (~311 K)
    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
2026-10-25 Add stage-2 CFD results and stage-2 CFX setup notes
    - docs/04_stage2_cfd_results.md: design-point results against the meanline,
    three-way work check, impeller-exit data, entropy loss split and the
    averaging uncertainty at the non-uniform outlet.
    - CFD guide A7: 600 kPa reference, Table Generation ranges for R134a,
    +600 kPa in expressions, Δh0-based post-processing, r2 isosurface,
    AppStream/OneDrive restore note.
    - cfd_postprocess.py: --fluid r134a and --dh0 options.
    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
2026-10-26 Report: add stage-2 CFD results section and figures
    - New section 7 (stage-2 CFD results): setup changes, performance vs
    meanline, work and angular-momentum checks, loss location and the
    averaging uncertainty, flow-field figures, y+ and limitations.
    - report/figures/: stage-2 Post figures (relative Mach at three spans,
    absolute Mach, Cr at the impeller exit, tip-leakage streamlines,
    meridional plots, r·Cθ chart).
    - docs/04: angular momentum through the diffuser, figure notes, y+.
    - Blade loading left as a placeholder until the main blade and splitter
    are separated from the CSV.
    Claude-Session: https://claude.ai/code/session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
2026-10-27 Add impeller manufacturing / CAM study and machining drawings
    - scripts/cam_analysis.py: passage width, blade height, ruling twist and
    flank-milling error, removal volume, finishing areas, cycle-time and
    balance estimates from the CAD blade geometry -> docs/cam_summary.json.
    - scripts/make_mfg_drawings.py: MFG-101/102 impeller machining drawings
    (datums A/B/C, GD&T, inspection plan), MFG-110 blank/turning/fixture,
    MFG-120 5-axis CAM plan with tool-access and flank-error charts.
    - docs/05_manufacturing_cam.md: process route, workholding, toolpath
    strategy, CAM software workflow, inspection/balance/spin, 3-D print notes.
    - impeller_geometry.py: factor blade construction into stage_bl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
2026-10-27 Add impeller mounting schematic: clamped stack vs shrink fit
    Half-sections of the rotor stack from layout.py, showing the load path,
    torque-carrying faces and fit for each method.
    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
